sdorunts/Low-Freq-Amp/README.md

# Low-Freq-Amp
My analog circuitry engineering course work
