sdorunts/Low-Freq-Amp/Documentation/Presentation.pptx

МИНИСТЕРСТВО НАУКИ И ВЫСШЕГО ОБРАЗОВАНИЯ РОССИЙСКОЙ ФЕДЕРАЦИИ
МОСКОВСКИЙ ГОСУДАРСТВЕННЫЙ ТЕХНИЧЕСКИЙ УНИВЕРСИТЕТ
ИМ. Н.Э. БАУМАНА
КАФЕДРА ПРОЕКТИРОВАНИЕ И ТЕХНОЛОГИЯ ПРОИЗВОДСТВА ЭЛЕКТРОННОЙ АППАРАТУРЫ


Отчет о выполнении курсового проекта по предмету «Основы аналогово-цифровой схемотехники» по теме «Разработка, моделирование и экспериментальные исследования усилителя низкой частоты»


Выполнил: студент группы ИУ4-52Б
Дорунц Ш.А.
Проверил: д.т.н., профессор, профессор каф. ИУ-4
Семенцов С.Г.



Москва, 2023 г.

## Slide 2

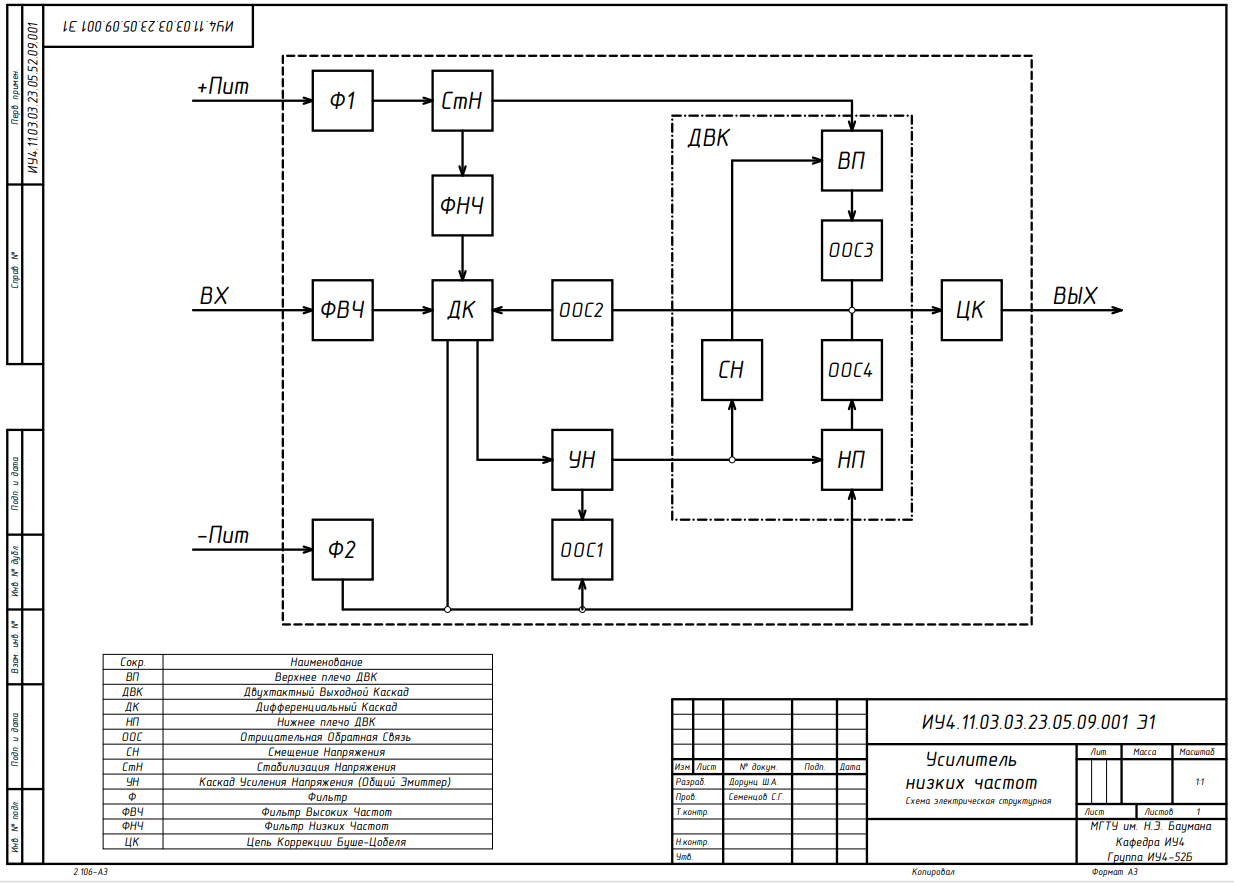
[picture p1: figure]

## Slide 3

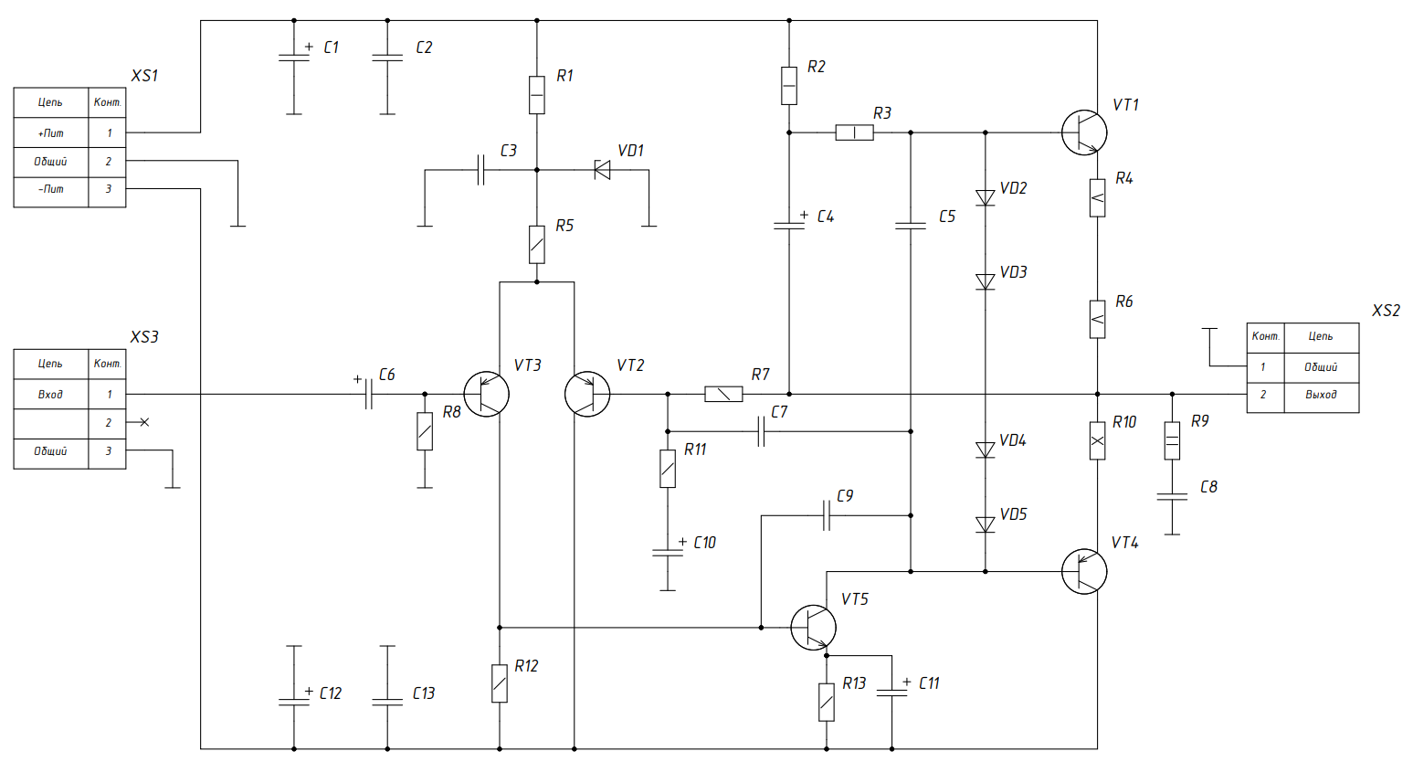
[picture p2: figure]

## Slide 4

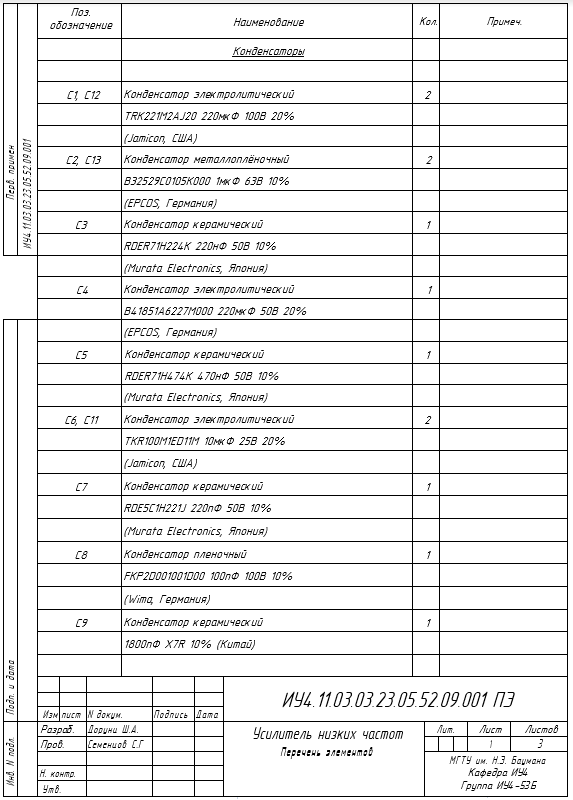
[picture p3: figure]
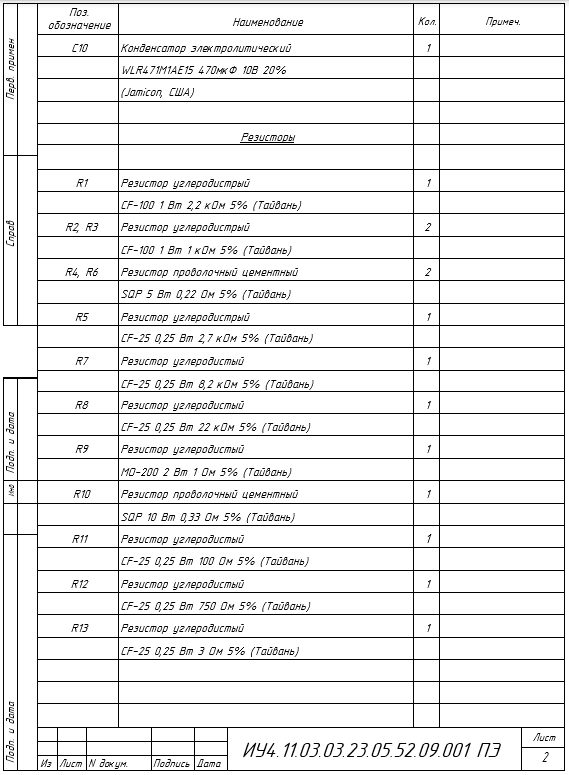
[picture p4: figure]

## Slide 5

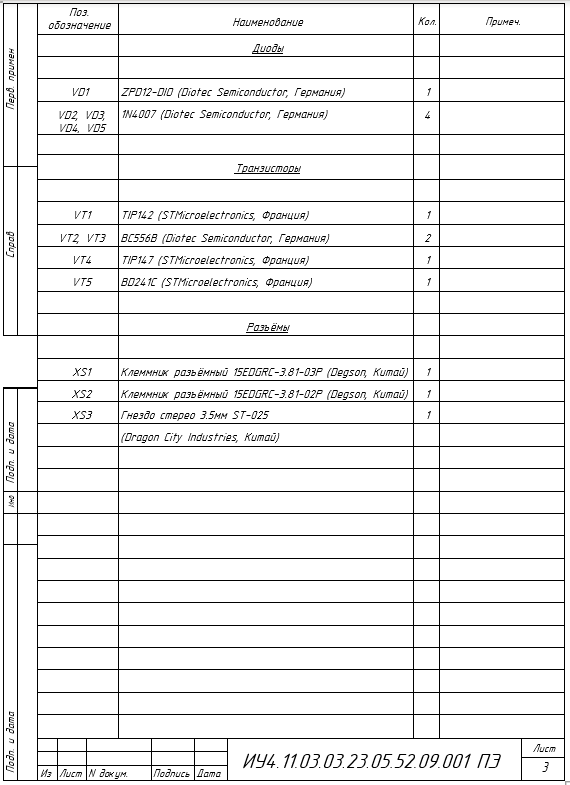
[picture p5: figure]

## Slide 6

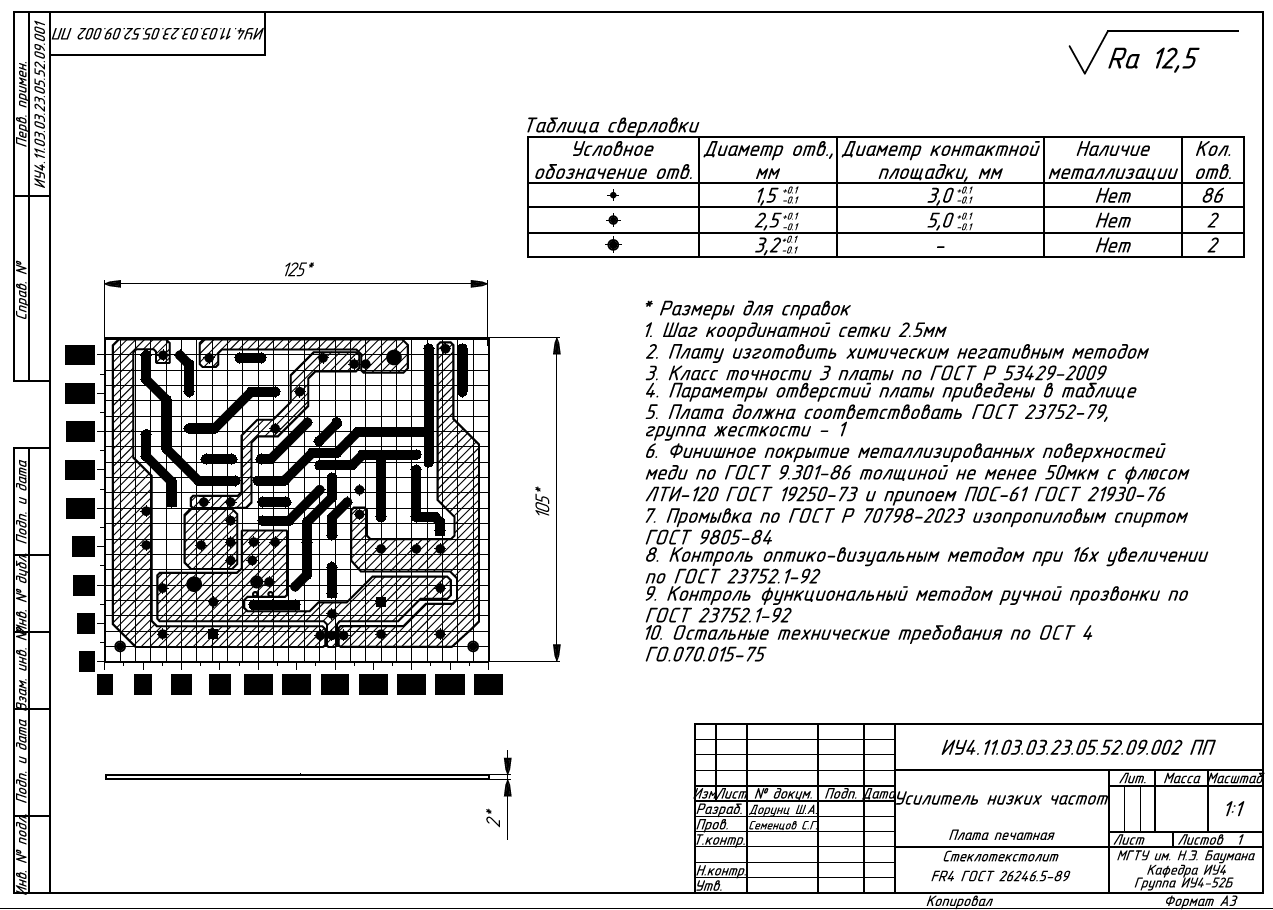
[picture p6: figure]
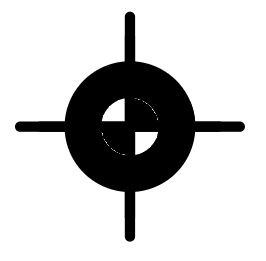
[picture p7: figure]
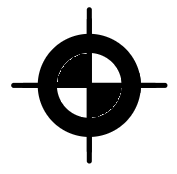
[picture p8: figure]
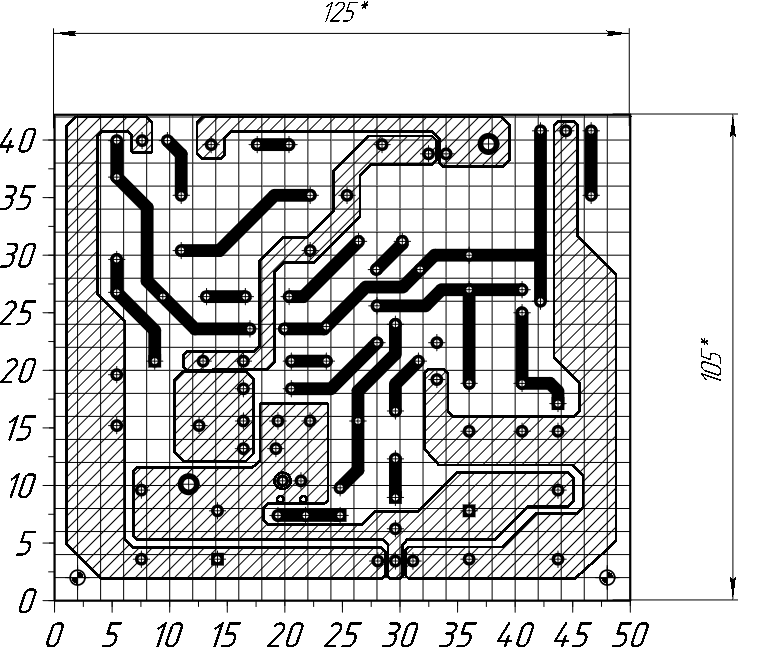
[picture p9: figure]
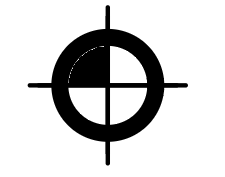
[picture p10: figure]

## Slide 7

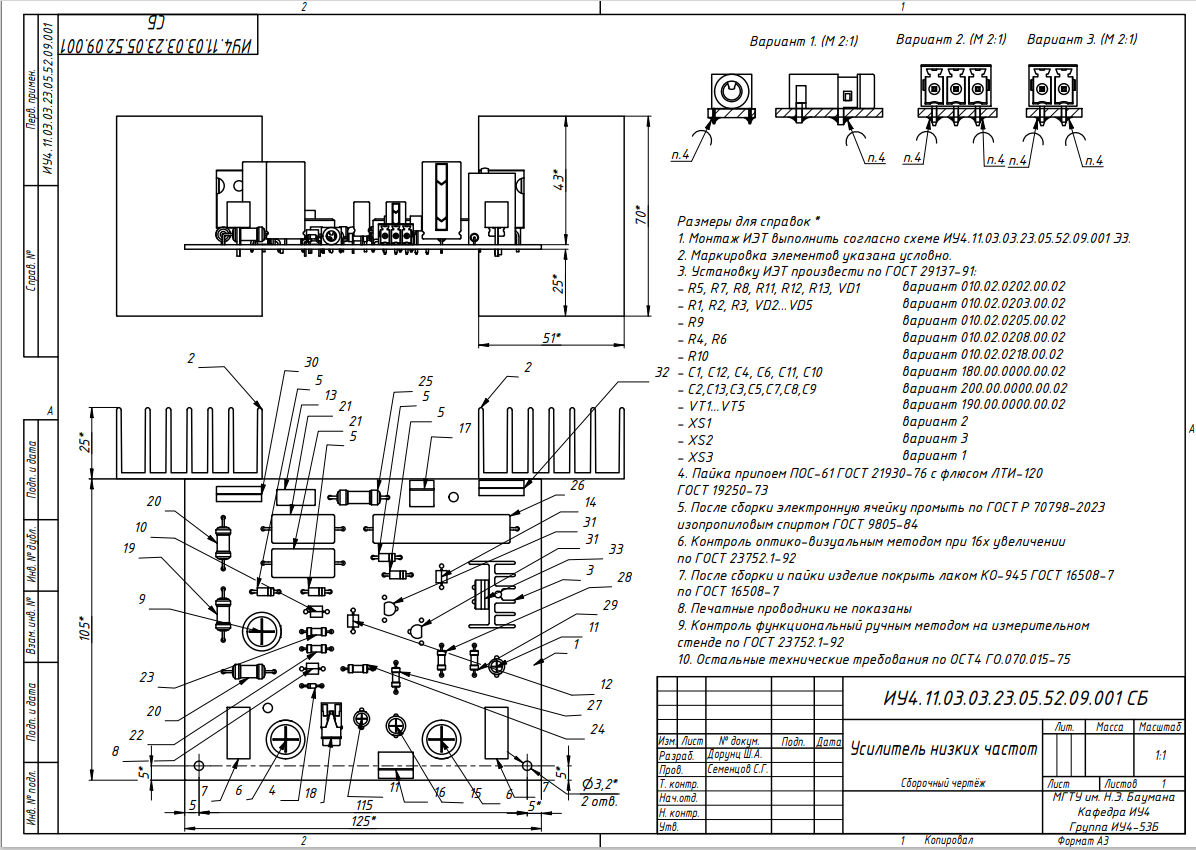
[picture p11: figure]

## Slide 8

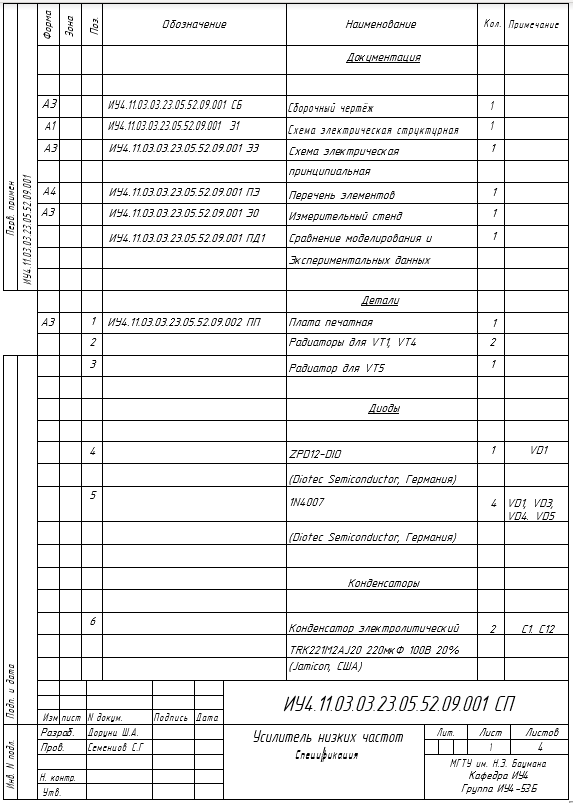
[picture p12: figure]
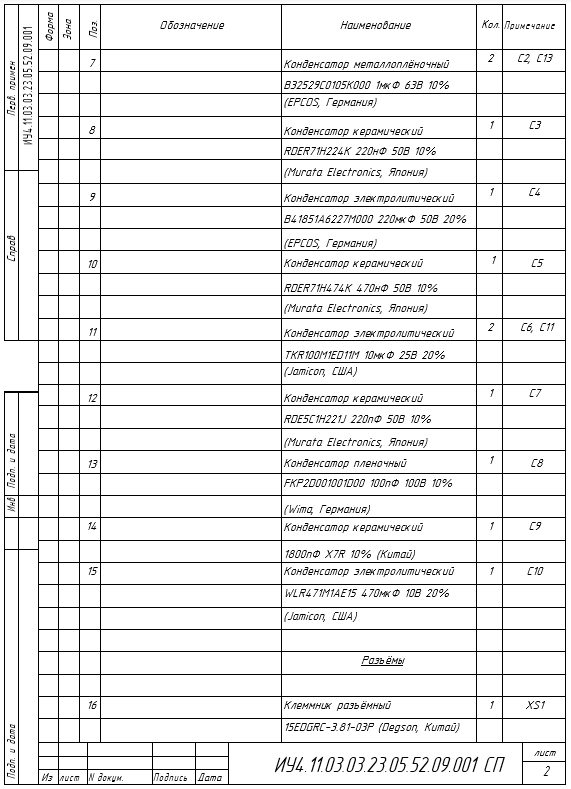
[picture p13: figure]

## Slide 9

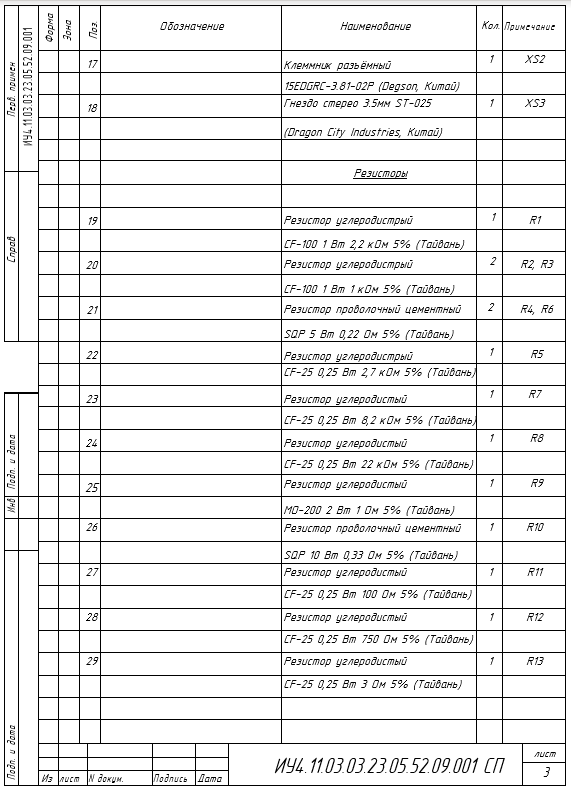
[picture p14: figure]
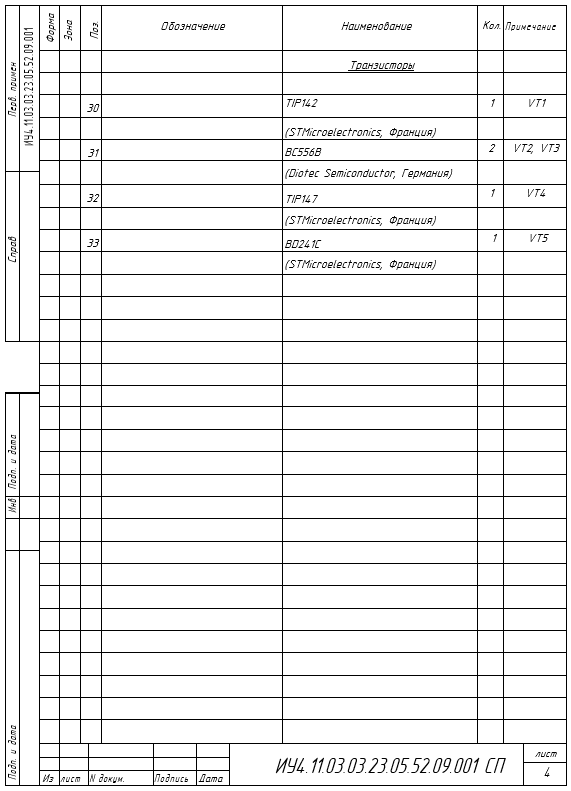
[picture p15: figure]

## Slide 10

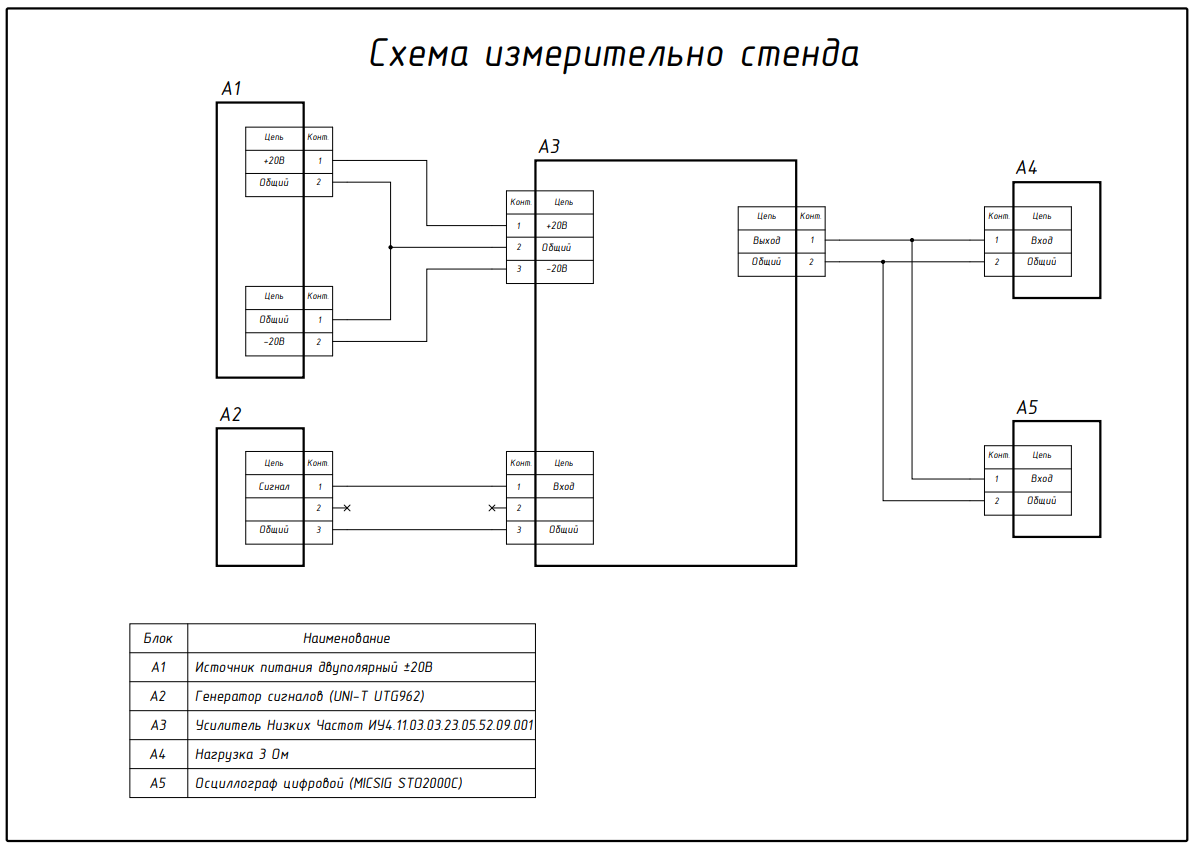
[picture p16: figure]

## Slide 11

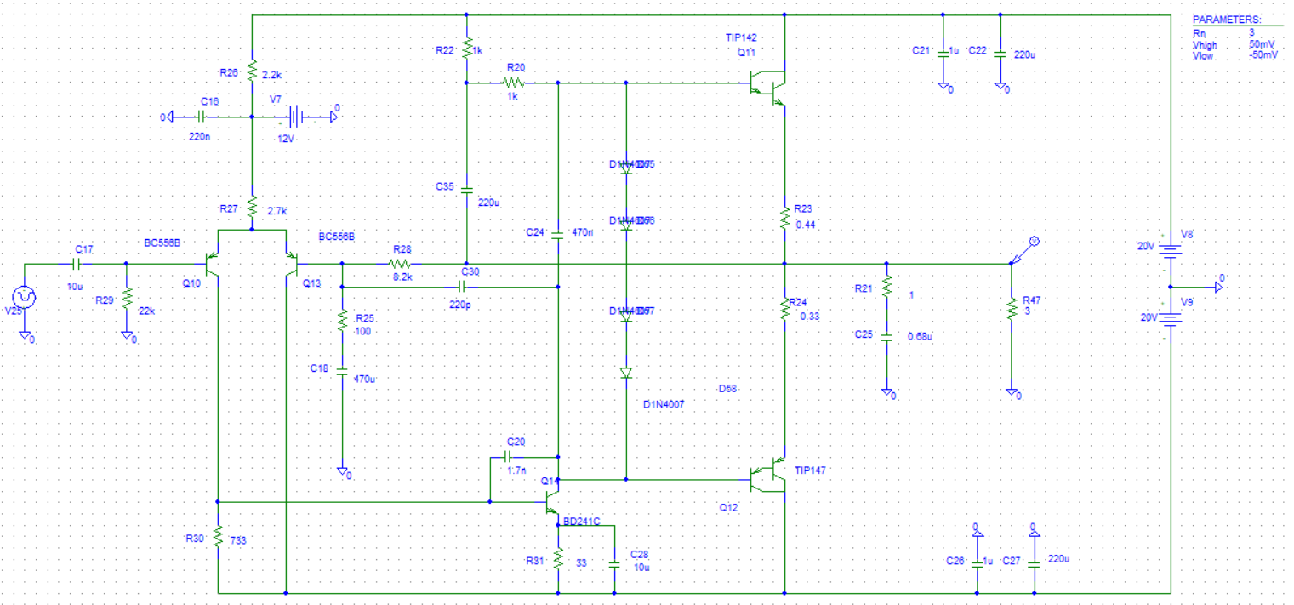
[picture p17: figure]

## Slide 12

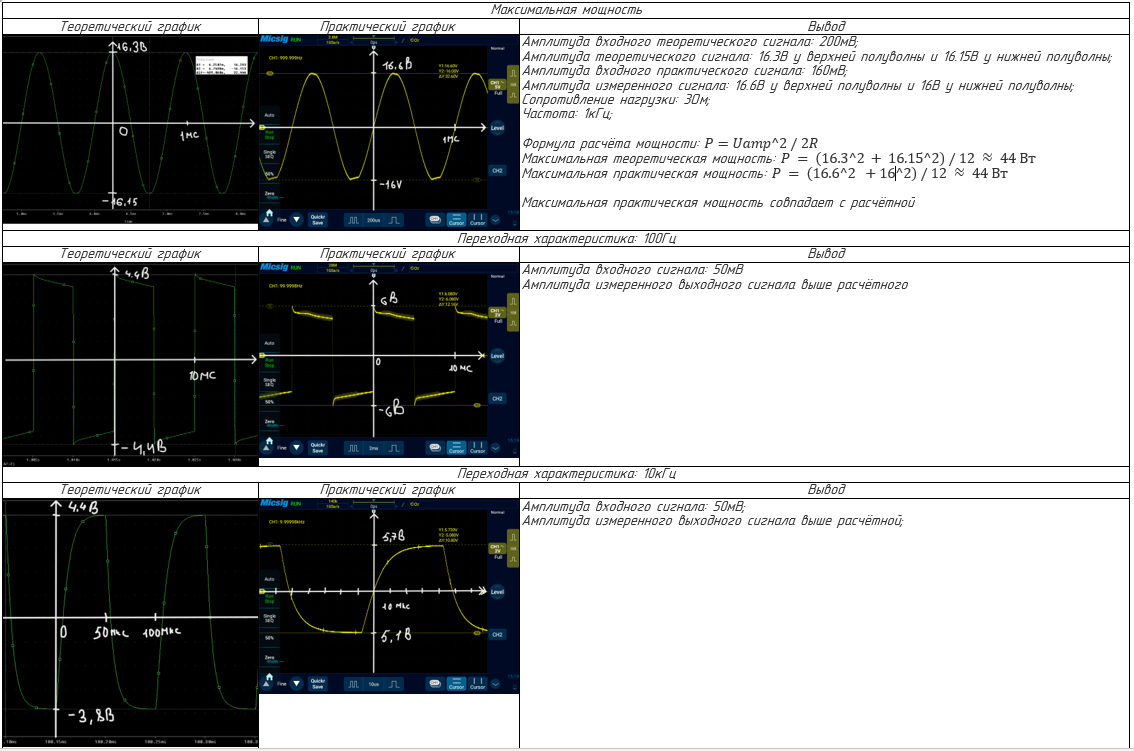
[picture p18: figure]

## Slide 13

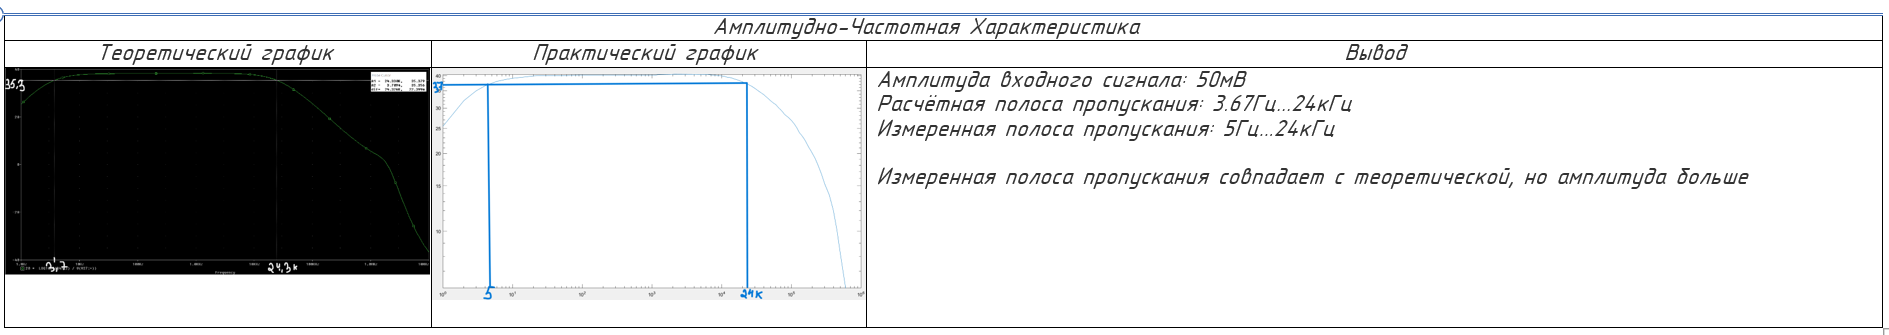
[picture p19: figure]
