sdorunts/Low-Freq-Amp/Documentation/ПД2_Дорунц.docx

Максимальная мощность
Теоретический график | Практический график | Вывод

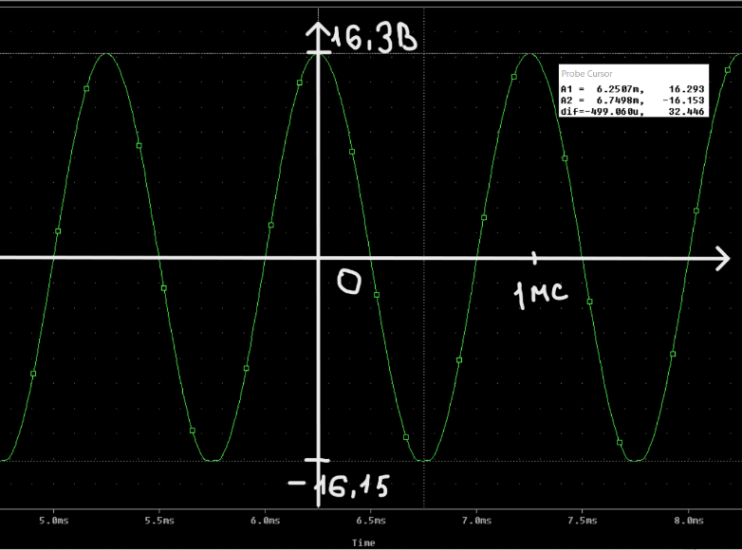
[picture p20: figure]
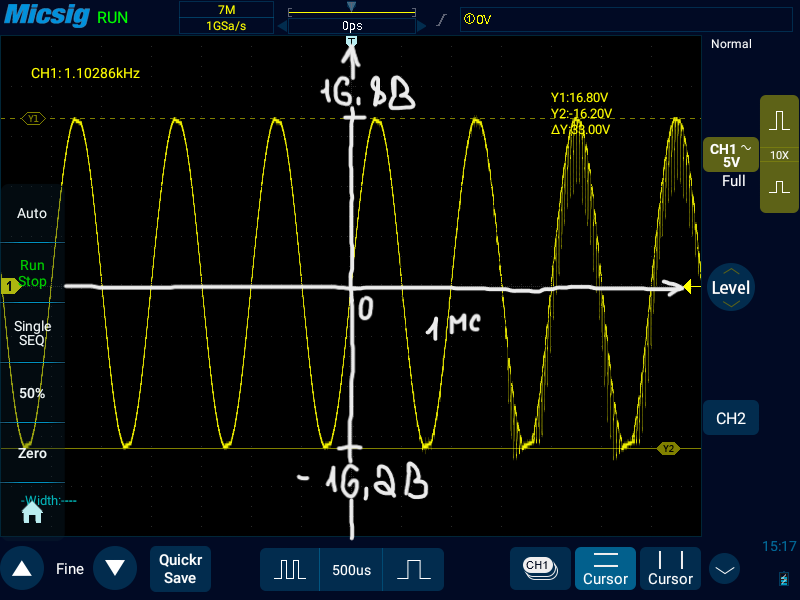
[picture p21: figure]

| | Амплитуда входного теоретического сигнала: 200мВ; Амплитуда теоретического сигнала: 16.3В у верхней полуволны и 16.15В у нижней полуволны; Амплитуда входного практического сигнала: 160мВ; Амплитуда измеренного сигнала: 16.8В у верхней полуволны и 16.2В у нижней полуволны; Сопротивление нагрузки: 3Ом; Частота: 1кГц; Формула расчёта мощности: P=Uamp^2 / 2R Максимальная теоретическая мощность: P = (16.3^2 + 16.15^2) / 6 ≈ 88 Вт Максимальная практическая мощность: P = (16.8^2 +16.2^2) / 6 ≈ 91 Вт Максимальная практическая мощность практически совпадает с расчётной

Переходная характеристика: 100Гц
Теоретический график | Практический график | Вывод

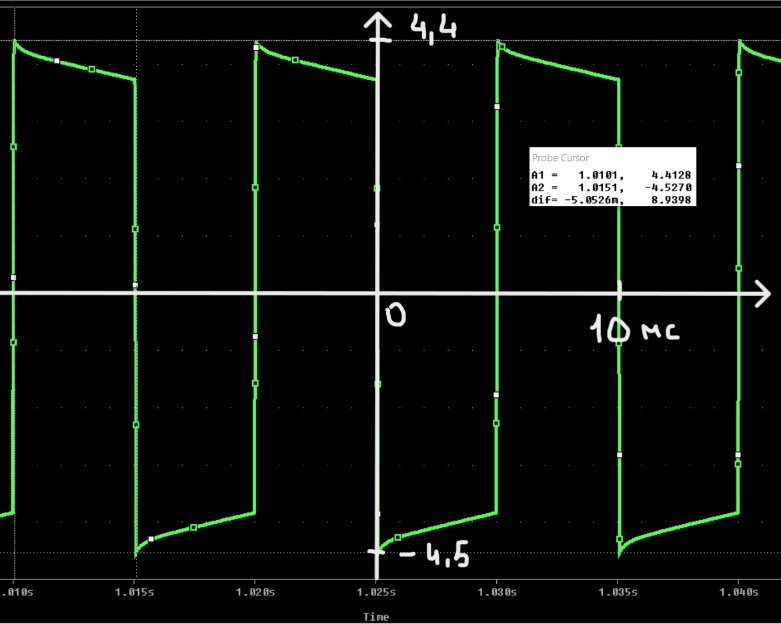
[picture p22: figure]
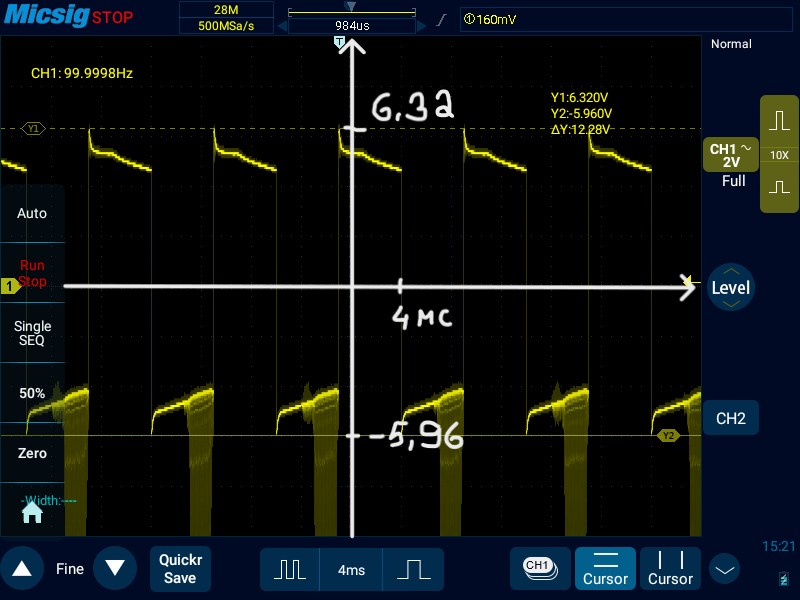
[picture p23: figure]

| | Амплитуда входного сигнала: 50мВ Амплитуда измеренного выходного сигнала выше расчётного

Переходная характеристика: 10кГц
Теоретический график | Практический график | Вывод

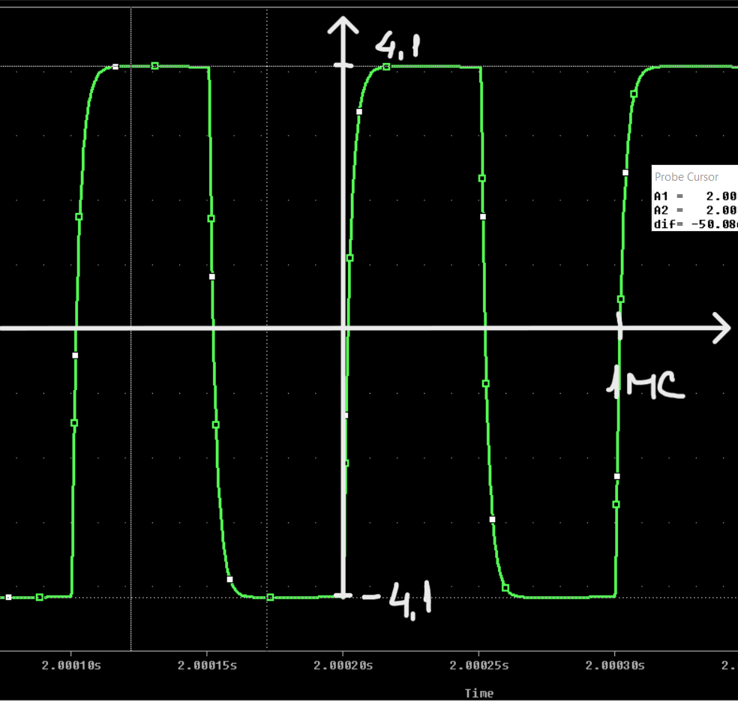
[picture p24: figure]
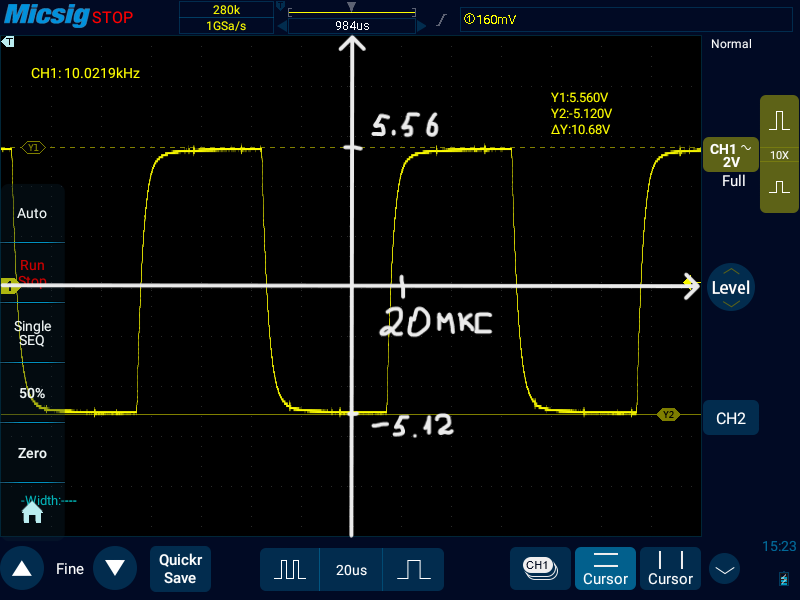
[picture p25: figure]

| | Амплитуда входного сигнала: 50мВ; Амплитуда измеренного выходного сигнала выше расчётной;

Амплитудно-Частотная Характеристика
Теоретический график | Практический график | Вывод

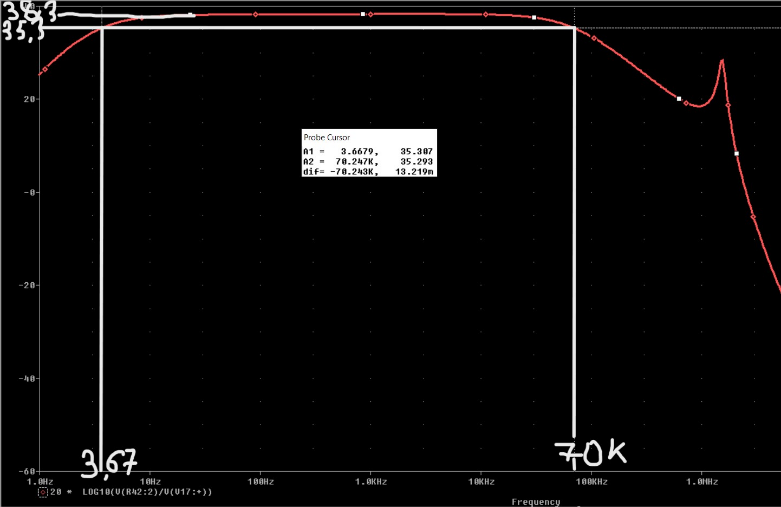
[picture p26: figure]
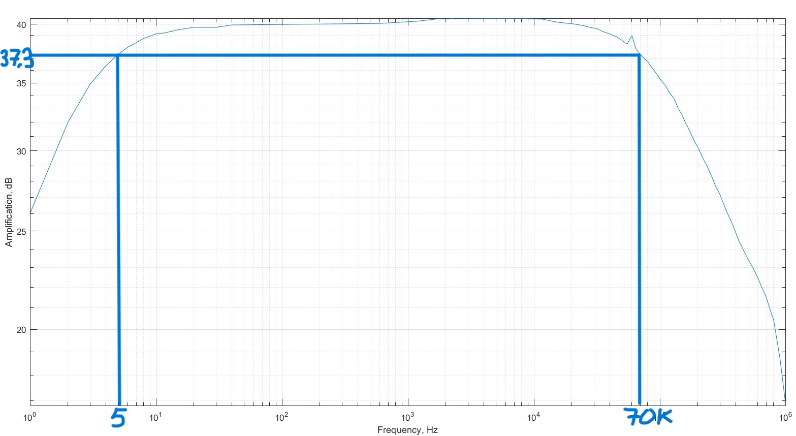
[picture p27: figure]

| | Амплитуда входного сигнала: 50мВ Расчётная полоса пропускания: 3.67Гц...70кГц Измеренная полоса пропускания: 5Гц...70кГц Измеренная полоса пропускания совпадает с теоретической, но амплитуда больше
