sdorunts/Low-Freq-Amp/Ar. sdorunts. Kurs. Osc/AFC; Vin=50mV; Rn=3Ohm; practical; marked.png

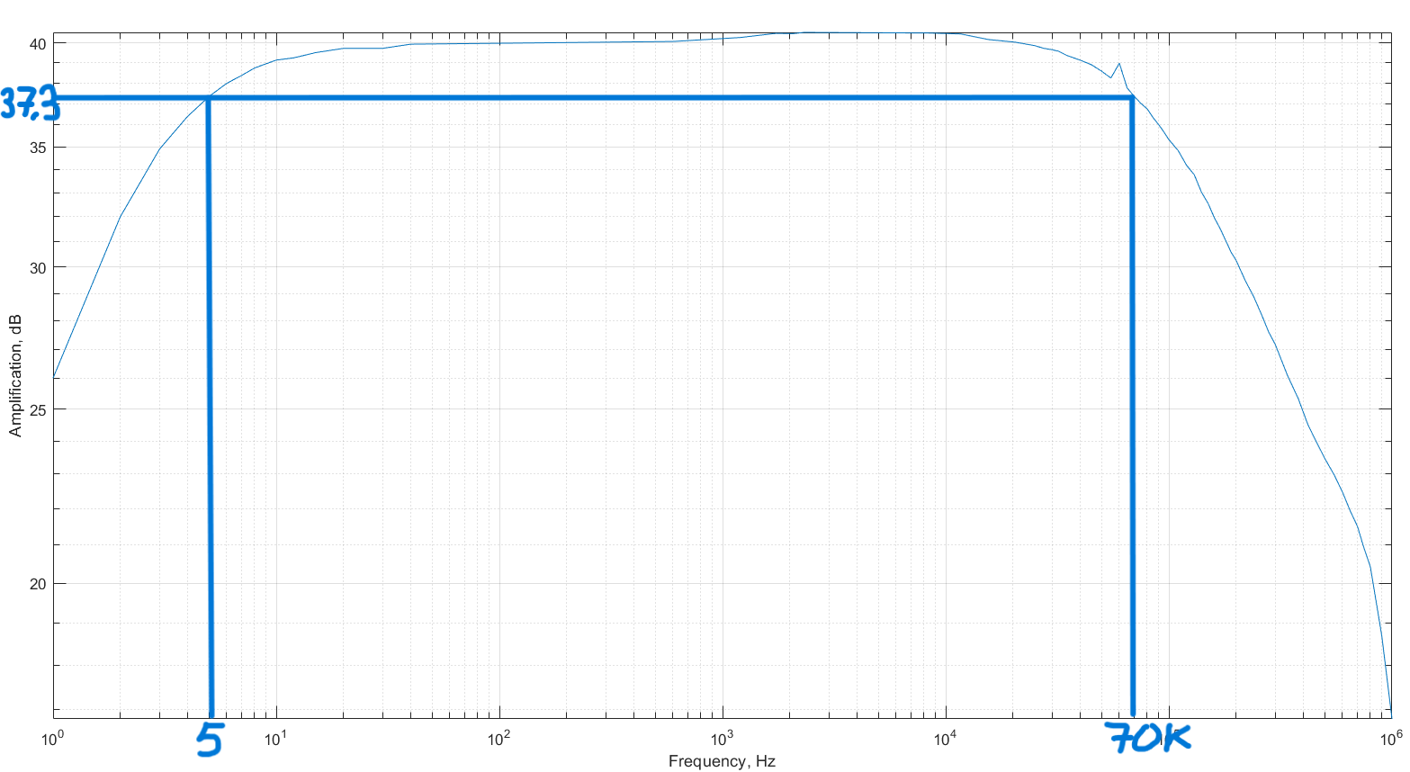
Ar. sdorunts. Kurs. Osc/AFC; Vin=50mV; Rn=3Ohm; practical; marked.png
