sdorunts/Low-Freq-Amp/Ar. sdorunts. Kurs. Osc/Screenshot_2023-12-09-14-33-51.png

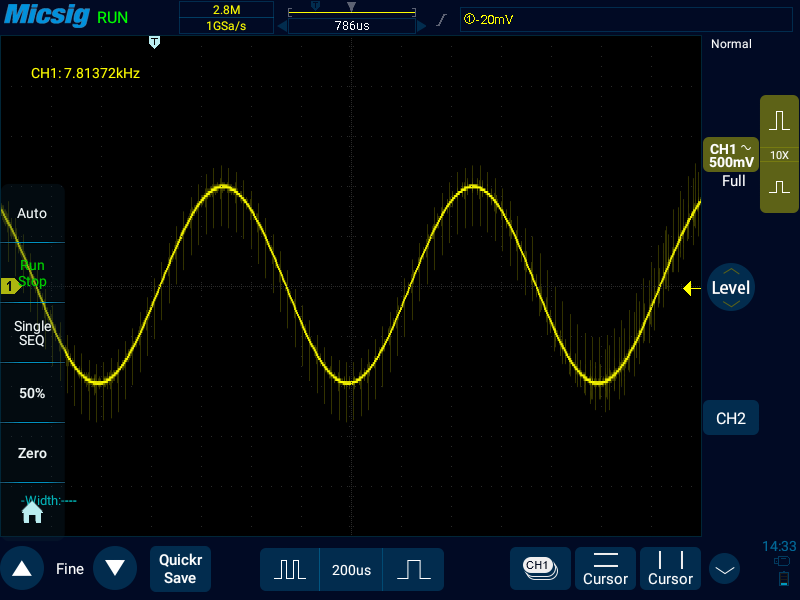
Ar. sdorunts. Kurs. Osc/Screenshot_2023-12-09-14-33-51.png
