sdorunts/Low-Freq-Amp/Ar. sdorunts. Kurs. Osc/Screenshot_2023-12-09-15-18-03.png

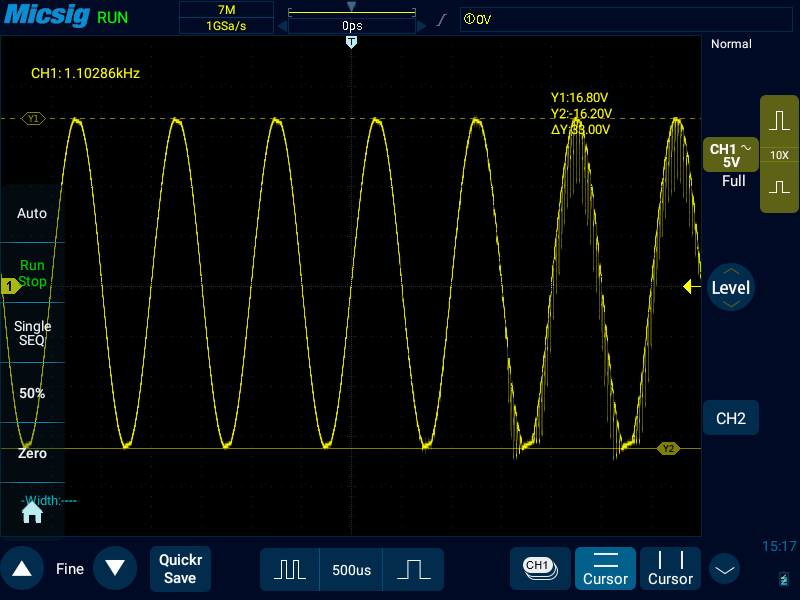
Ar. sdorunts. Kurs. Osc/Screenshot_2023-12-09-15-18-03.png
