sdorunts/Low-Freq-Amp/Ar. sdorunts. Kurs. Osc/Screenshot_2023-12-09-15-22-10.png

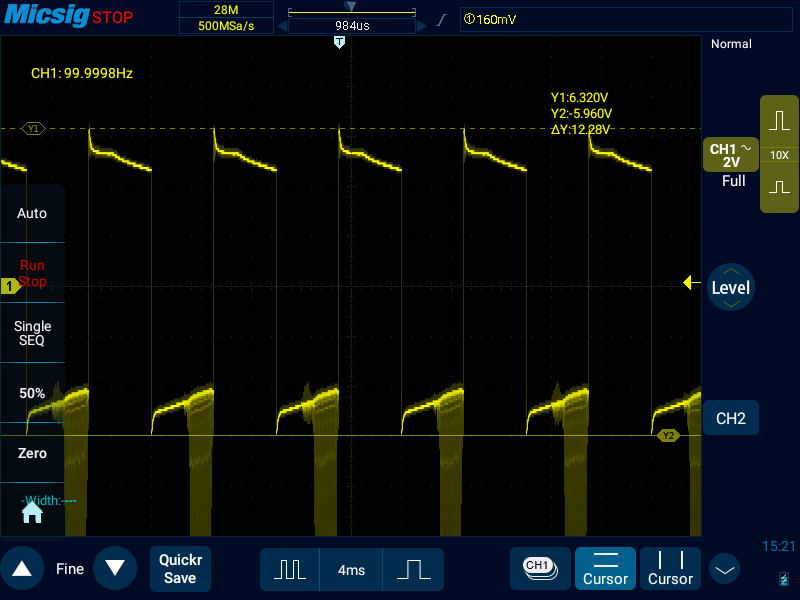
Ar. sdorunts. Kurs. Osc/Screenshot_2023-12-09-15-22-10.png
