sdorunts/Low-Freq-Amp/Ar. sdorunts. Kurs. Osc/Screenshot_2023-12-09-15-40-26.png

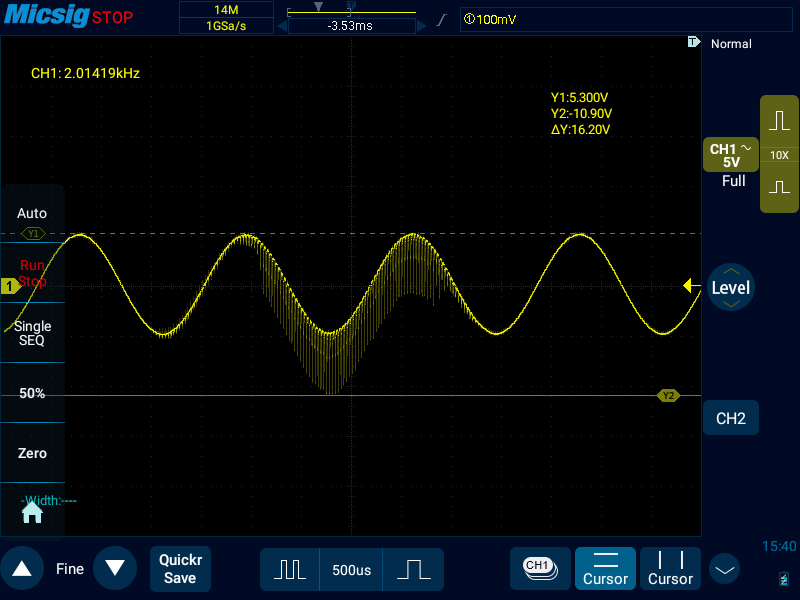
Ar. sdorunts. Kurs. Osc/Screenshot_2023-12-09-15-40-26.png
