sdorunts/Low-Freq-Amp/Ar. sdorunts. Kurs. Osc/Screenshot_2023-12-09-16-49-15.png

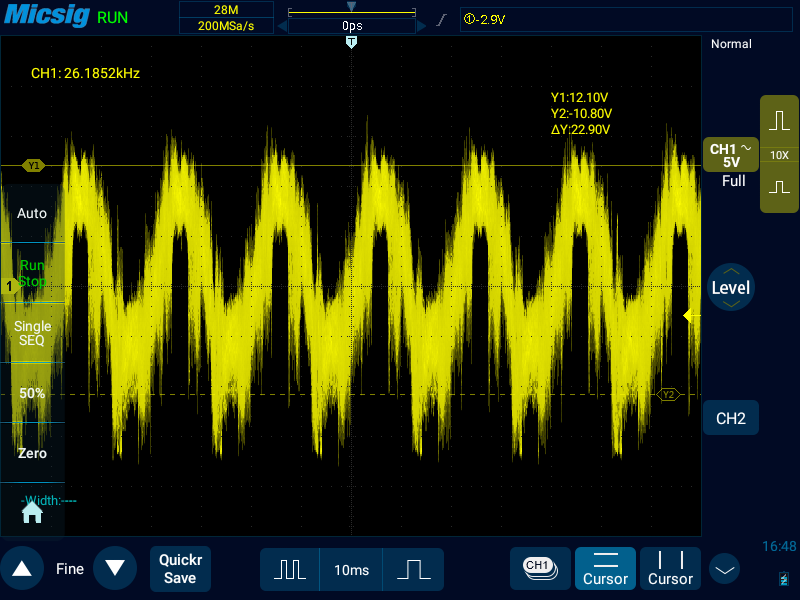
Ar. sdorunts. Kurs. Osc/Screenshot_2023-12-09-16-49-15.png
