sdorunts/Low-Freq-Amp/Ar. sdorunts. Kurs. Osc/Screenshot_2023-12-09-18-22-20.png

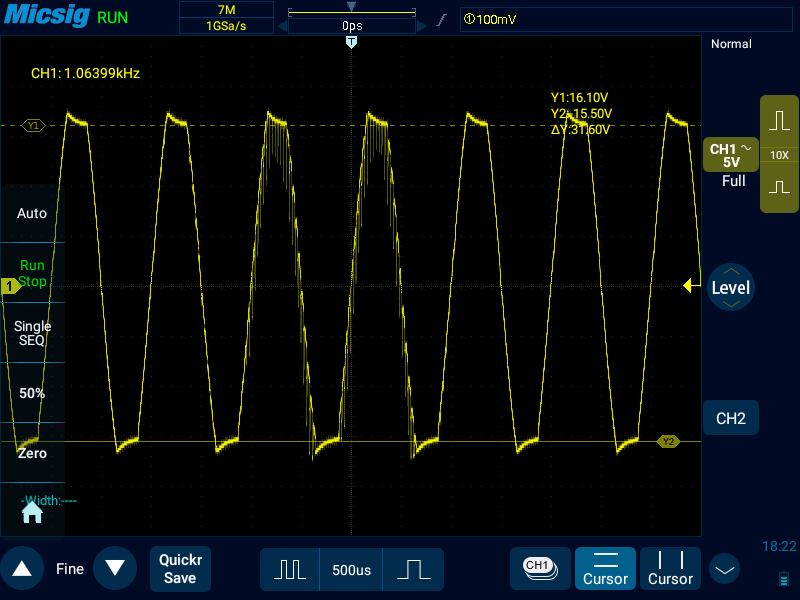
Ar. sdorunts. Kurs. Osc/Screenshot_2023-12-09-18-22-20.png
