sdorunts/Low-Freq-Amp/Documentation/Осциллограммы/АЧХ.PNG

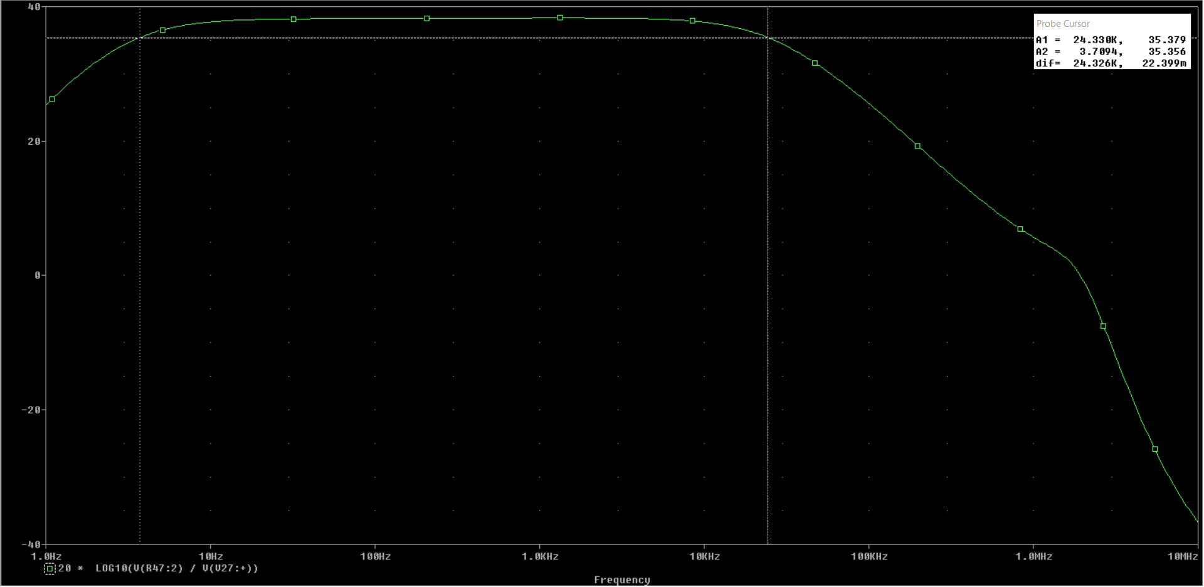
Documentation/Осциллограммы/АЧХ.PNG
