sdorunts/Low-Freq-Amp/Documentation/Осциллограммы/АЧХ_практика.PNG

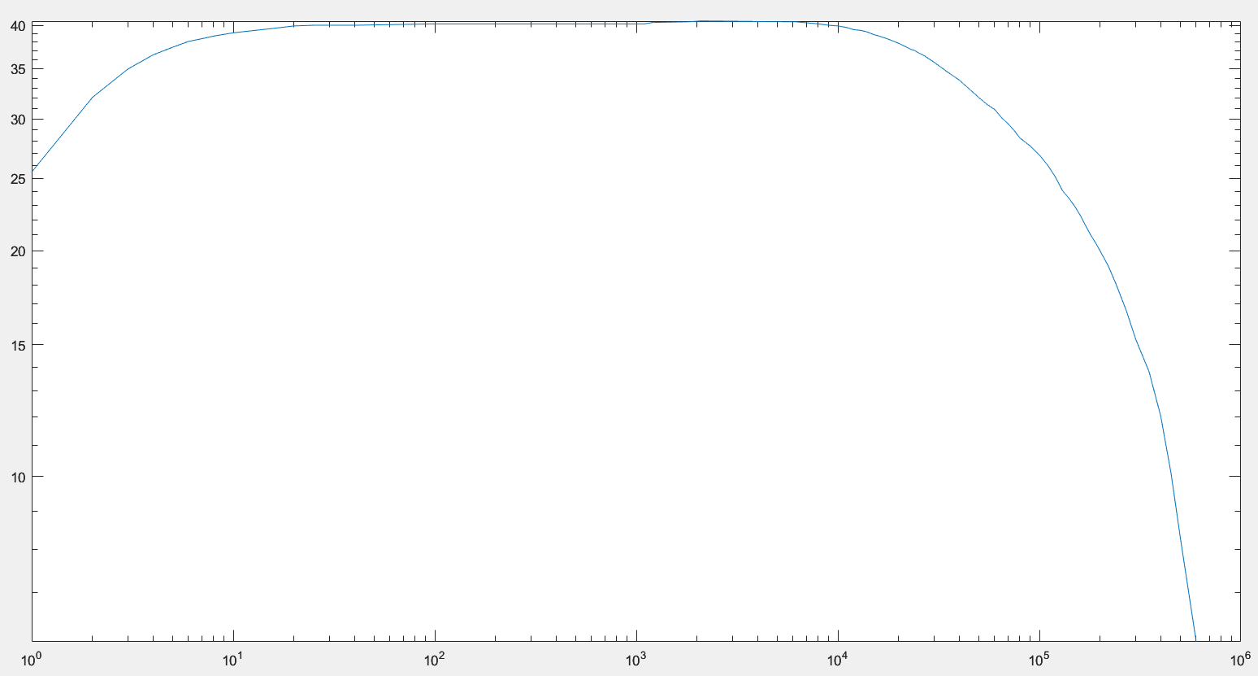
Documentation/Осциллограммы/АЧХ_практика.PNG
