sdorunts/Low-Freq-Amp/Documentation/Осциллограммы/Переходная. 10кГц.PNG

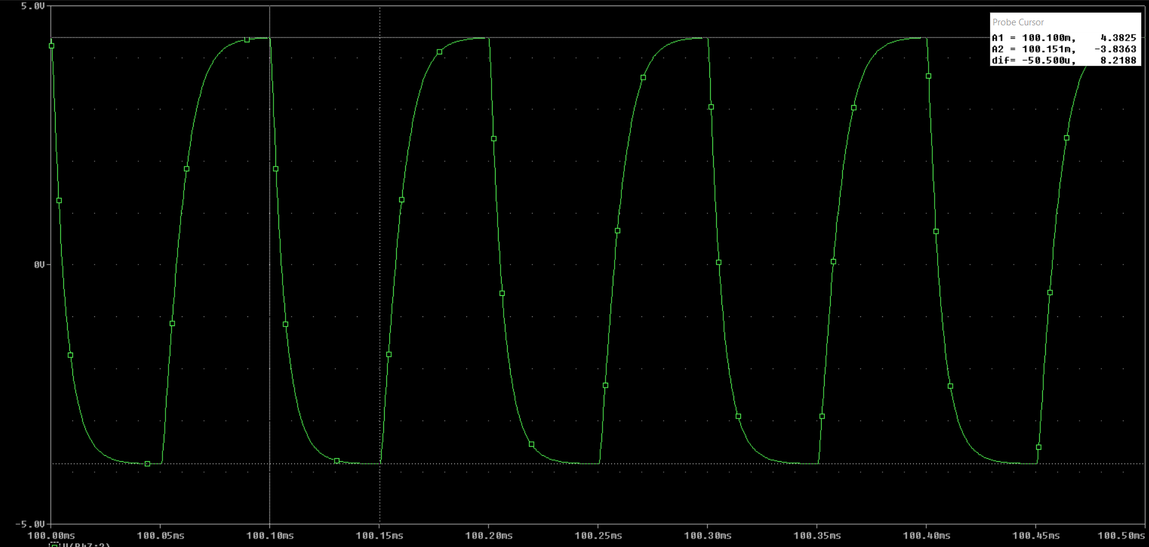
Documentation/Осциллограммы/Переходная. 10кГц.PNG
