sdorunts/Low-Freq-Amp/Documentation/Осциллограммы/Переходная. 100Гц.PNG

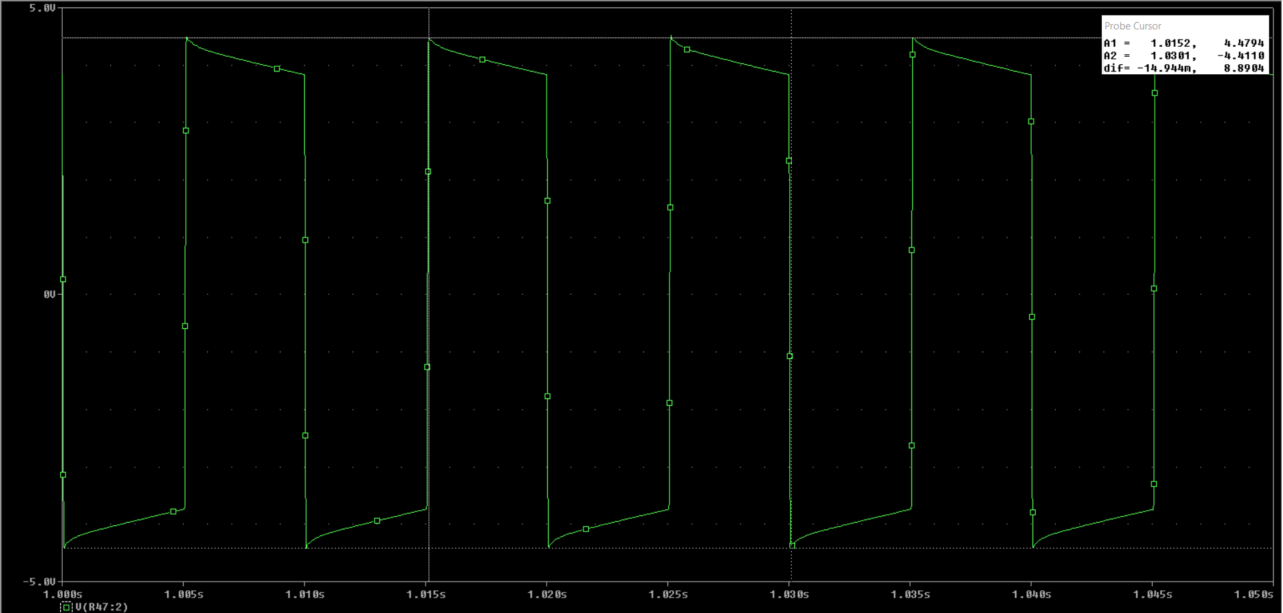
Documentation/Осциллограммы/Переходная. 100Гц.PNG
