sdorunts/Low-Freq-Amp/Documentation/ПП_Дорунц.png

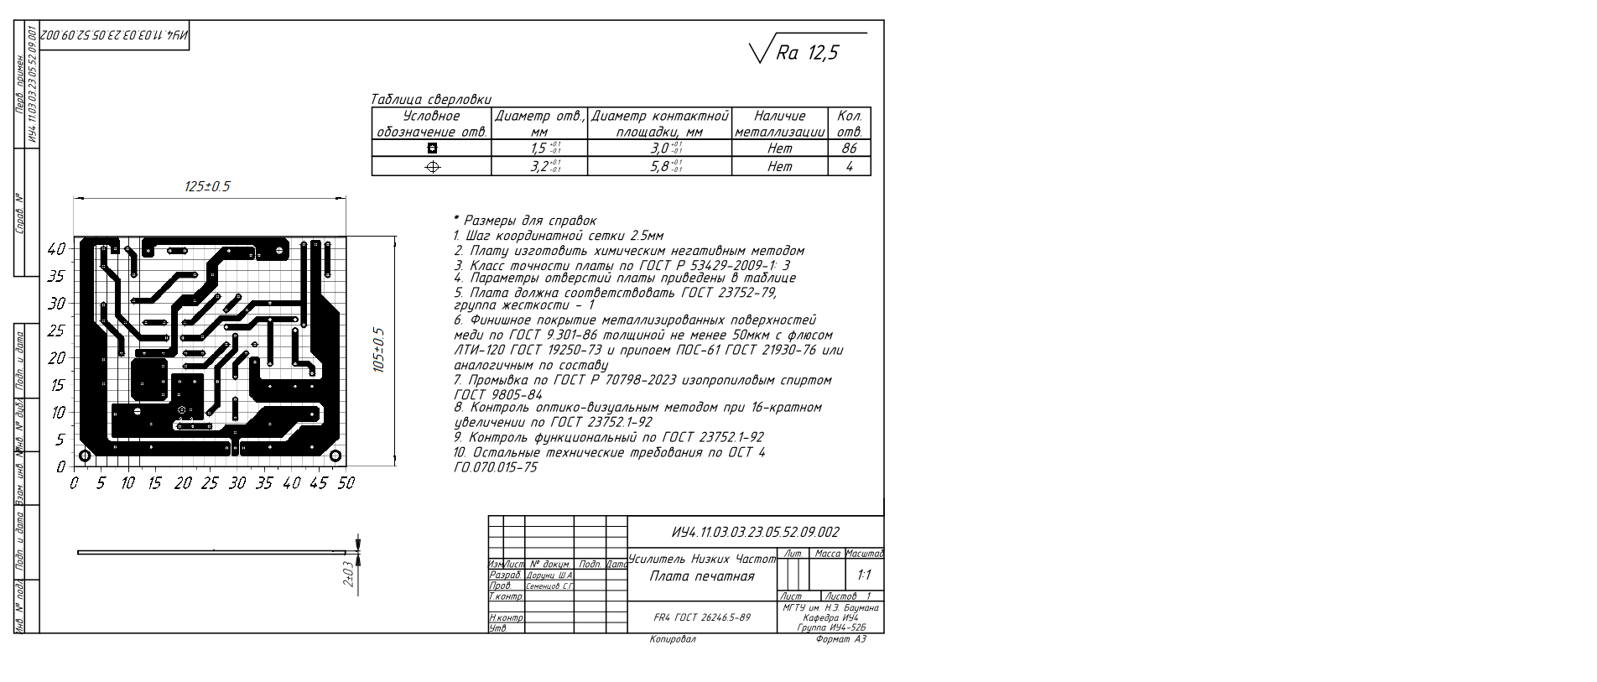
Documentation/ПП_Дорунц.png
