sdorunts/Low-Freq-Amp/Simulation/Graphics/AFC; Vin=50mV; Rn=3Ohm.PNG

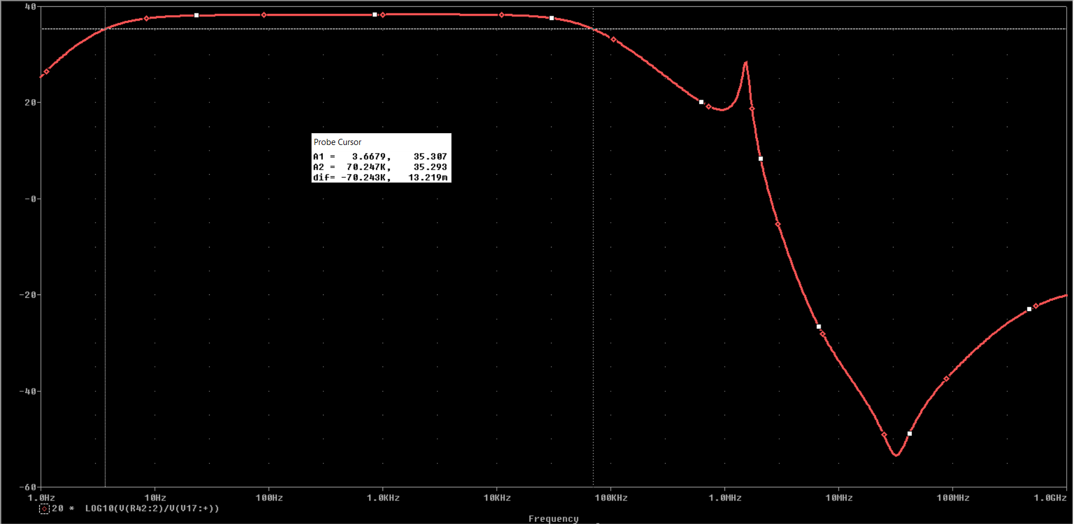
Simulation/Graphics/AFC; Vin=50mV; Rn=3Ohm.PNG
