sdorunts/Low-Freq-Amp/Simulation/Graphics/AFC; Vin=50mV; Rn=3Ohm; 0.5Meg;.PNG

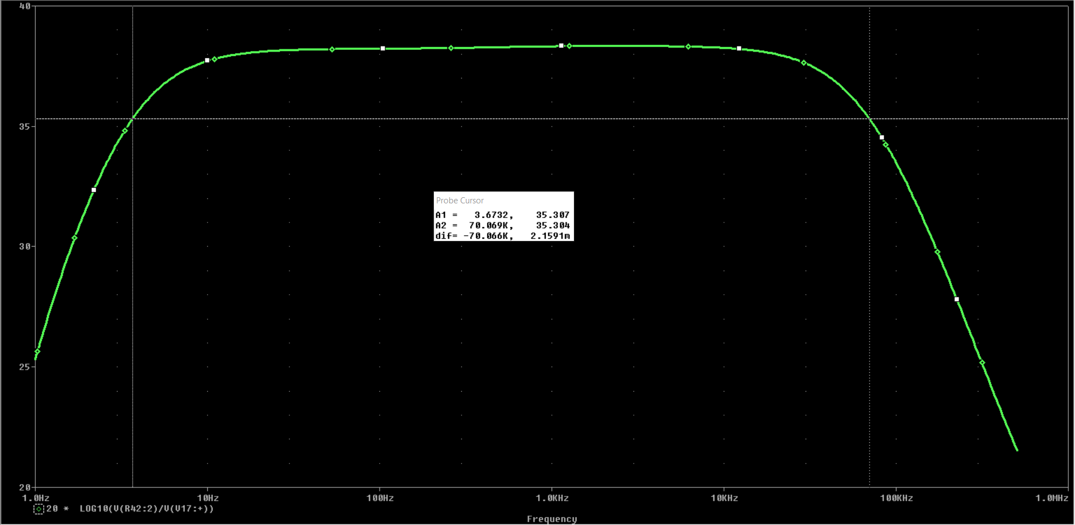
Simulation/Graphics/AFC; Vin=50mV; Rn=3Ohm; 0.5Meg;.PNG
