sdorunts/Low-Freq-Amp/Simulation/Graphics/Max. Power; Vin=200mV; Rn=3Ohm; f=1k.PNG

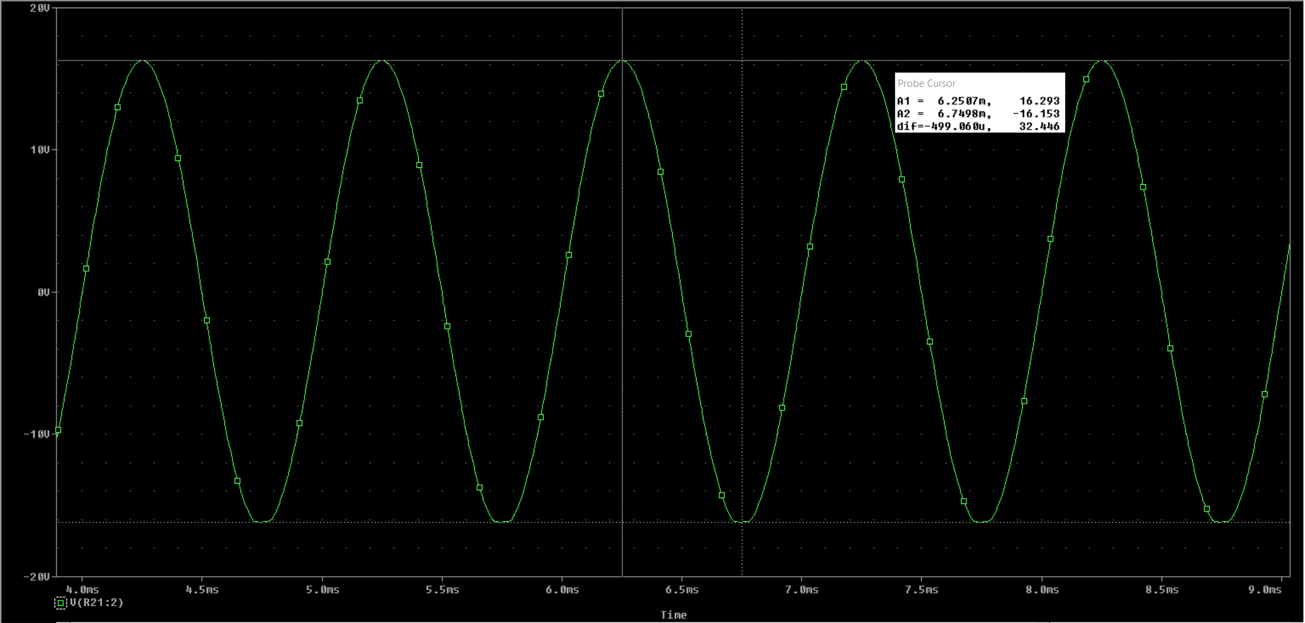
Simulation/Graphics/Max. Power; Vin=200mV; Rn=3Ohm; f=1k.PNG
