sdorunts/Low-Freq-Amp/Project Outputs for Kursovaya/PCBv2.step

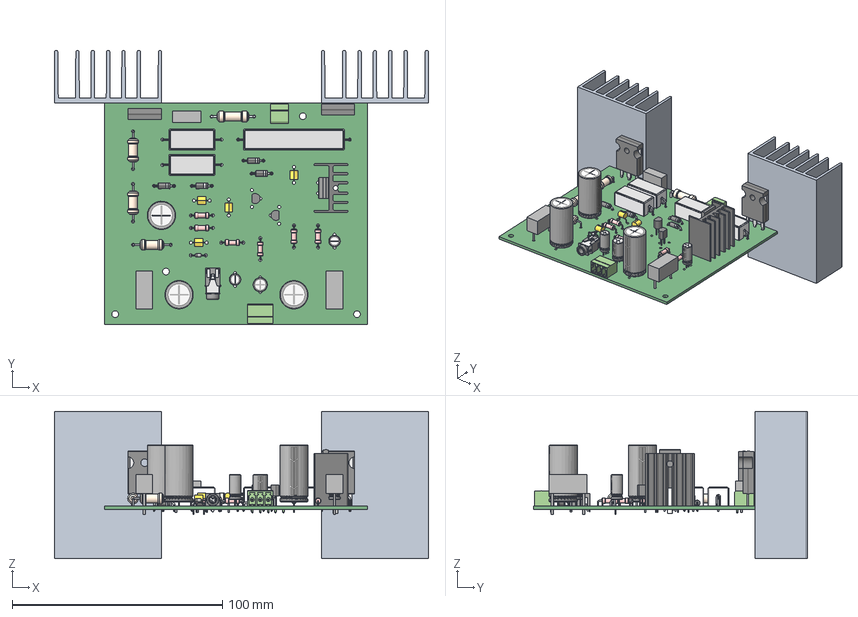
[picture p68: CAD file, 2023-12-19]
Project Outputs for Kursovaya/PCBv2.step
177.9 x 130.5 x 70.0 mm
RESAR2750W80L2200T1000H900_5W x 2
RESAR5334W80L4800T1000H900_10W
res-20.32_15.2x5.1
Telo konektora
Kontakt most
Kontakt 1
Kontakt 2
15EDGRC-3.81-02P-14-00A(H)_RGB5220458
15EDGRC-3.81-03P-14-00A(H)_RGB5220458
DO_41_375mil001 x 4
DO_41_375mil x 4
DO_41_375mil003 x 4
DO35_7mm-pitch
User Library-Transistors TO-220 FULLPAK 3-PIN
User Library-TO-247AC_plate_cuted x 2
User Library-TO-247AC_pino1 x 2
User Library-TO-247AC_pino2 x 2
User Library-TO-247AC_pino3 x 2
User Library-TO-247AC_body_finished x 2
User Library-TO-92B x 2
res-10.35_6.8x2.8 x 6
res-17.78_11.4x5.1 x 3
cappr-2_5.5h12 x 2
cappr-5_13.5h27 x 3
Extruded x 3
cappr-2.5_6.8h12
K10-17-0805 x 4
Radiator HS-123-25 v2
radiator x 2
