sdorunts/Low-Freq-Amp/(list of files, cad)

Other CAD files:
Documentation/PCBv2.dwg
Documentation/OldVersions/PCBv2.0011.dwg
Project Outputs for Kursovaya/PCBv2.dwg
Project Outputs for Kursovaya/PCBv2/15EDGRC-3.81-02P-14-00A(H)_RGB5220458.ipt
Project Outputs for Kursovaya/PCBv2/15EDGRC-3.81-03P-14-00A(H)_RGB5220458.ipt
Project Outputs for Kursovaya/PCBv2/6338724944.iam
Project Outputs for Kursovaya/PCBv2/6338725344.iam
Project Outputs for Kursovaya/PCBv2/6381688880.iam
Project Outputs for Kursovaya/PCBv2/6381689040.iam
Project Outputs for Kursovaya/PCBv2/Audio Jack 3.5 mm Cliff FC68125.iam
Project Outputs for Kursovaya/PCBv2/Board.iam
Project Outputs for Kursovaya/PCBv2/C1.iam
Project Outputs for Kursovaya/PCBv2/C10.iam
Project Outputs for Kursovaya/PCBv2/C11.iam
Project Outputs for Kursovaya/PCBv2/C12.iam
Project Outputs for Kursovaya/PCBv2/C13.iam
Project Outputs for Kursovaya/PCBv2/C2.iam
Project Outputs for Kursovaya/PCBv2/C3.iam
Project Outputs for Kursovaya/PCBv2/C4.iam
Project Outputs for Kursovaya/PCBv2/C5.iam
Project Outputs for Kursovaya/PCBv2/C6.iam
Project Outputs for Kursovaya/PCBv2/C7.iam
Project Outputs for Kursovaya/PCBv2/C8.iam
Project Outputs for Kursovaya/PCBv2/C9.iam
Project Outputs for Kursovaya/PCBv2/Cylinder.ipt
Project Outputs for Kursovaya/PCBv2/Cylinder_1.ipt
Project Outputs for Kursovaya/PCBv2/DO35_7mm-pitch.ipt
Project Outputs for Kursovaya/PCBv2/DO_41_375mil.ipt
Project Outputs for Kursovaya/PCBv2/DO_41_375mil001.ipt
Project Outputs for Kursovaya/PCBv2/DO_41_375mil003.ipt
Project Outputs for Kursovaya/PCBv2/Extruded.ipt
Project Outputs for Kursovaya/PCBv2/Extruded_1.ipt
Project Outputs for Kursovaya/PCBv2/Fillet.ipt
Project Outputs for Kursovaya/PCBv2/Fillet001.ipt
Project Outputs for Kursovaya/PCBv2/Free-Models.iam
Project Outputs for Kursovaya/PCBv2/K10-17-0805.ipt
Project Outputs for Kursovaya/PCBv2/Kontakt 1.ipt
Project Outputs for Kursovaya/PCBv2/Kontakt 2.ipt
Project Outputs for Kursovaya/PCBv2/Kontakt most.ipt
Project Outputs for Kursovaya/PCBv2/Open CASCADE STEP translator 7.5 1.1.1.ipt
Project Outputs for Kursovaya/PCBv2/PCBv2.iam
Project Outputs for Kursovaya/PCBv2/R1.iam
Project Outputs for Kursovaya/PCBv2/R10.iam
Project Outputs for Kursovaya/PCBv2/R11.iam
Project Outputs for Kursovaya/PCBv2/R12.iam
Project Outputs for Kursovaya/PCBv2/R13.iam
Project Outputs for Kursovaya/PCBv2/R2.iam
Project Outputs for Kursovaya/PCBv2/R3.iam
Project Outputs for Kursovaya/PCBv2/R4.iam
Project Outputs for Kursovaya/PCBv2/R5.iam
Project Outputs for Kursovaya/PCBv2/R6.iam
Project Outputs for Kursovaya/PCBv2/R7.iam
Project Outputs for Kursovaya/PCBv2/R8.iam
Project Outputs for Kursovaya/PCBv2/R9.iam
Project Outputs for Kursovaya/PCBv2/RESAR2750W80L2200T1000H900_5W.ipt
Project Outputs for Kursovaya/PCBv2/RESAR5334W80L4800T1000H900_10W.ipt
Project Outputs for Kursovaya/PCBv2/Radiator HS-123-25 v2.ipt
Project Outputs for Kursovaya/PCBv2/T1.iam
Project Outputs for Kursovaya/PCBv2/T2.iam
Project Outputs for Kursovaya/PCBv2/T3.iam
Project Outputs for Kursovaya/PCBv2/T4.iam
Project Outputs for Kursovaya/PCBv2/T5.iam
Project Outputs for Kursovaya/PCBv2/Telo konektora.ipt
Project Outputs for Kursovaya/PCBv2/User Library-DO-41_375mil.iam
Project Outputs for Kursovaya/PCBv2/User Library-TO-247AC.iam
Project Outputs for Kursovaya/PCBv2/User Library-TO-247AC_body_finished.ipt
Project Outputs for Kursovaya/PCBv2/User Library-TO-247AC_pino1.ipt
Project Outputs for Kursovaya/PCBv2/User Library-TO-247AC_pino2.ipt
Project Outputs for Kursovaya/PCBv2/User Library-TO-247AC_pino3.ipt
Project Outputs for Kursovaya/PCBv2/User Library-TO-247AC_plate_cuted.ipt
Project Outputs for Kursovaya/PCBv2/User Library-TO-92B.ipt
Project Outputs for Kursovaya/PCBv2/User Library-Transistors TO-220 FULLPAK 3-PIN.ipt
Project Outputs for Kursovaya/PCBv2/VD1.iam
Project Outputs for Kursovaya/PCBv2/VD2.iam
Project Outputs for Kursovaya/PCBv2/VD3.iam
Project Outputs for Kursovaya/PCBv2/VD4.iam
Project Outputs for Kursovaya/PCBv2/VD5.iam
Project Outputs for Kursovaya/PCBv2/XS1.iam
Project Outputs for Kursovaya/PCBv2/XS2.iam
Project Outputs for Kursovaya/PCBv2/XS3.iam
Project Outputs for Kursovaya/PCBv2/cappr-2.5_6.8h12.ipt
Project Outputs for Kursovaya/PCBv2/cappr-2_5.5h12.ipt
Project Outputs for Kursovaya/PCBv2/cappr-5_13.5h27.ipt
Project Outputs for Kursovaya/PCBv2/radiator.ipt
Project Outputs for Kursovaya/PCBv2/res-10.35_6.8x2.8.ipt
Project Outputs for Kursovaya/PCBv2/res-17.78_11.4x5.1.ipt
Project Outputs for Kursovaya/PCBv2/res-20.32_15.2x5.1.ipt
