sdorunts/Low-Freq-Amp/Simulation/Graphics/Transitional Characteristic; Vamp=50mV; Rn=3Ohm; f=10kHz; whitout Cursor.PNG

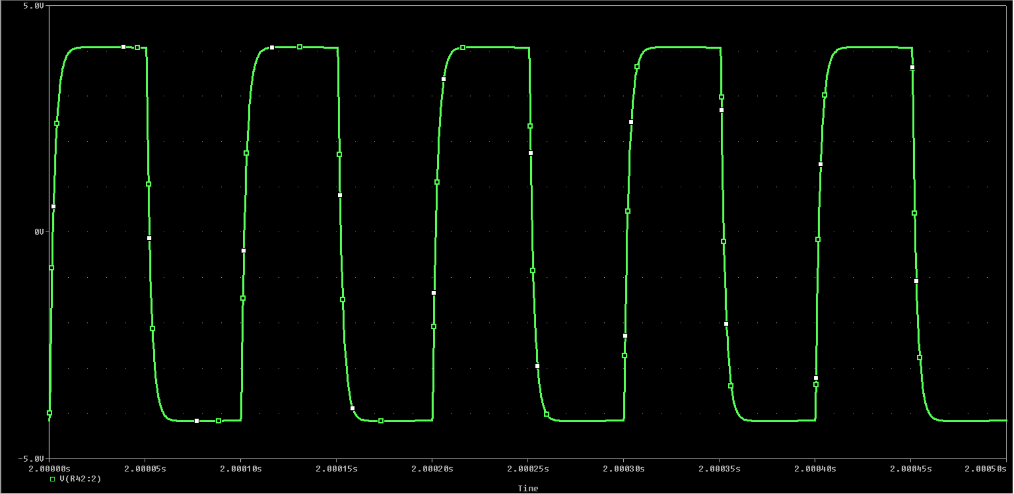
Simulation/Graphics/Transitional Characteristic; Vamp=50mV; Rn=3Ohm; f=10kHz; whitout Cursor.PNG
