sdorunts/Low-Freq-Amp/Simulation/Graphics/Transitional Characteristic; Vamp=50mV; Rn=3Ohm; f=100Hz.PNG

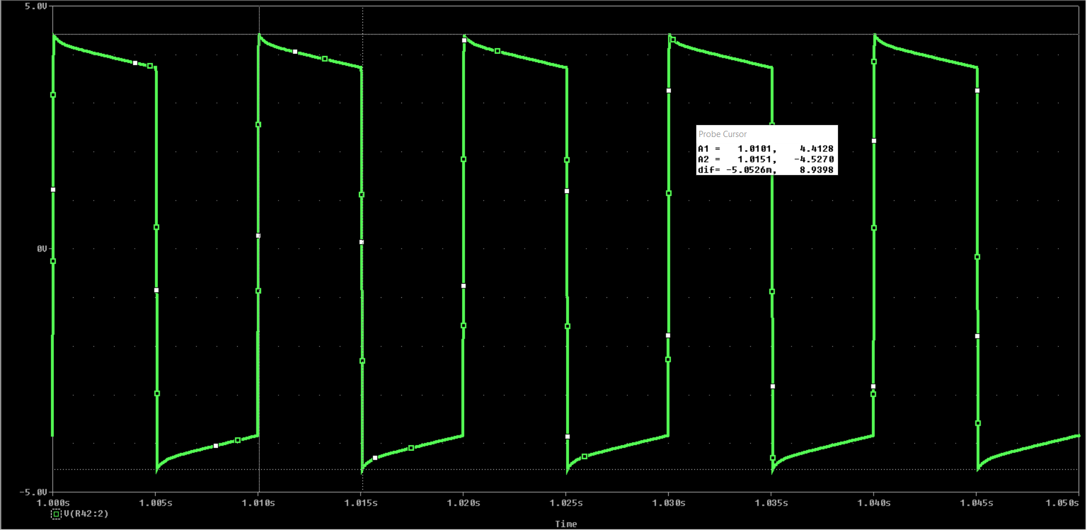
Simulation/Graphics/Transitional Characteristic; Vamp=50mV; Rn=3Ohm; f=100Hz.PNG
