sdorunts/Low-Freq-Amp/ИС.pdf

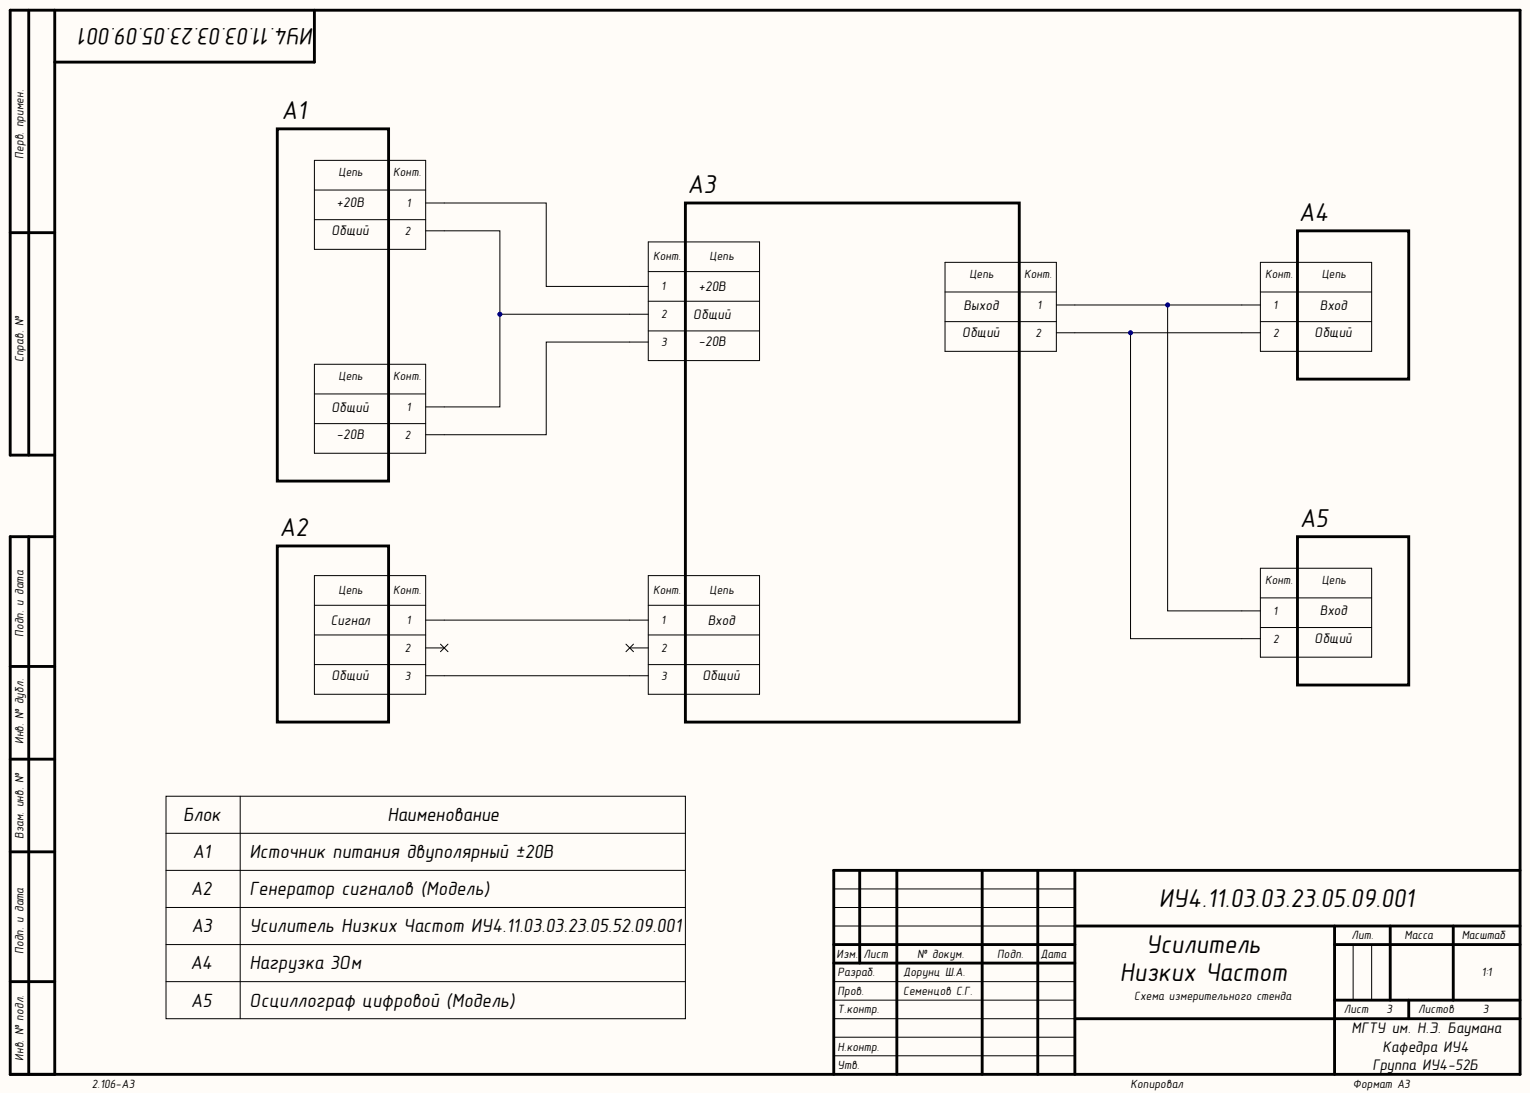
[picture p73: page 1]

Инв. № подл. Инв. № дубл. Подп. и дата Взам. инв. № Подп. и дата Перв. примен. Справ. №

Цепь | Конт.

Общий | 2

Конт. | Цепь

2 | Общий

Общий | 1

1 | Вход

Блок | Наименование

А1 | Источник питания двуполярный ±20В

Т.контр. | Лист 3 | Листов 3

МГТУ им. Н.Э. Баумана Кафедра ИУ4 Группа ИУ4-52Б

Н.контр.
Утв.
