sdorunts/Low-Freq-Amp/Kursovaya.pdf

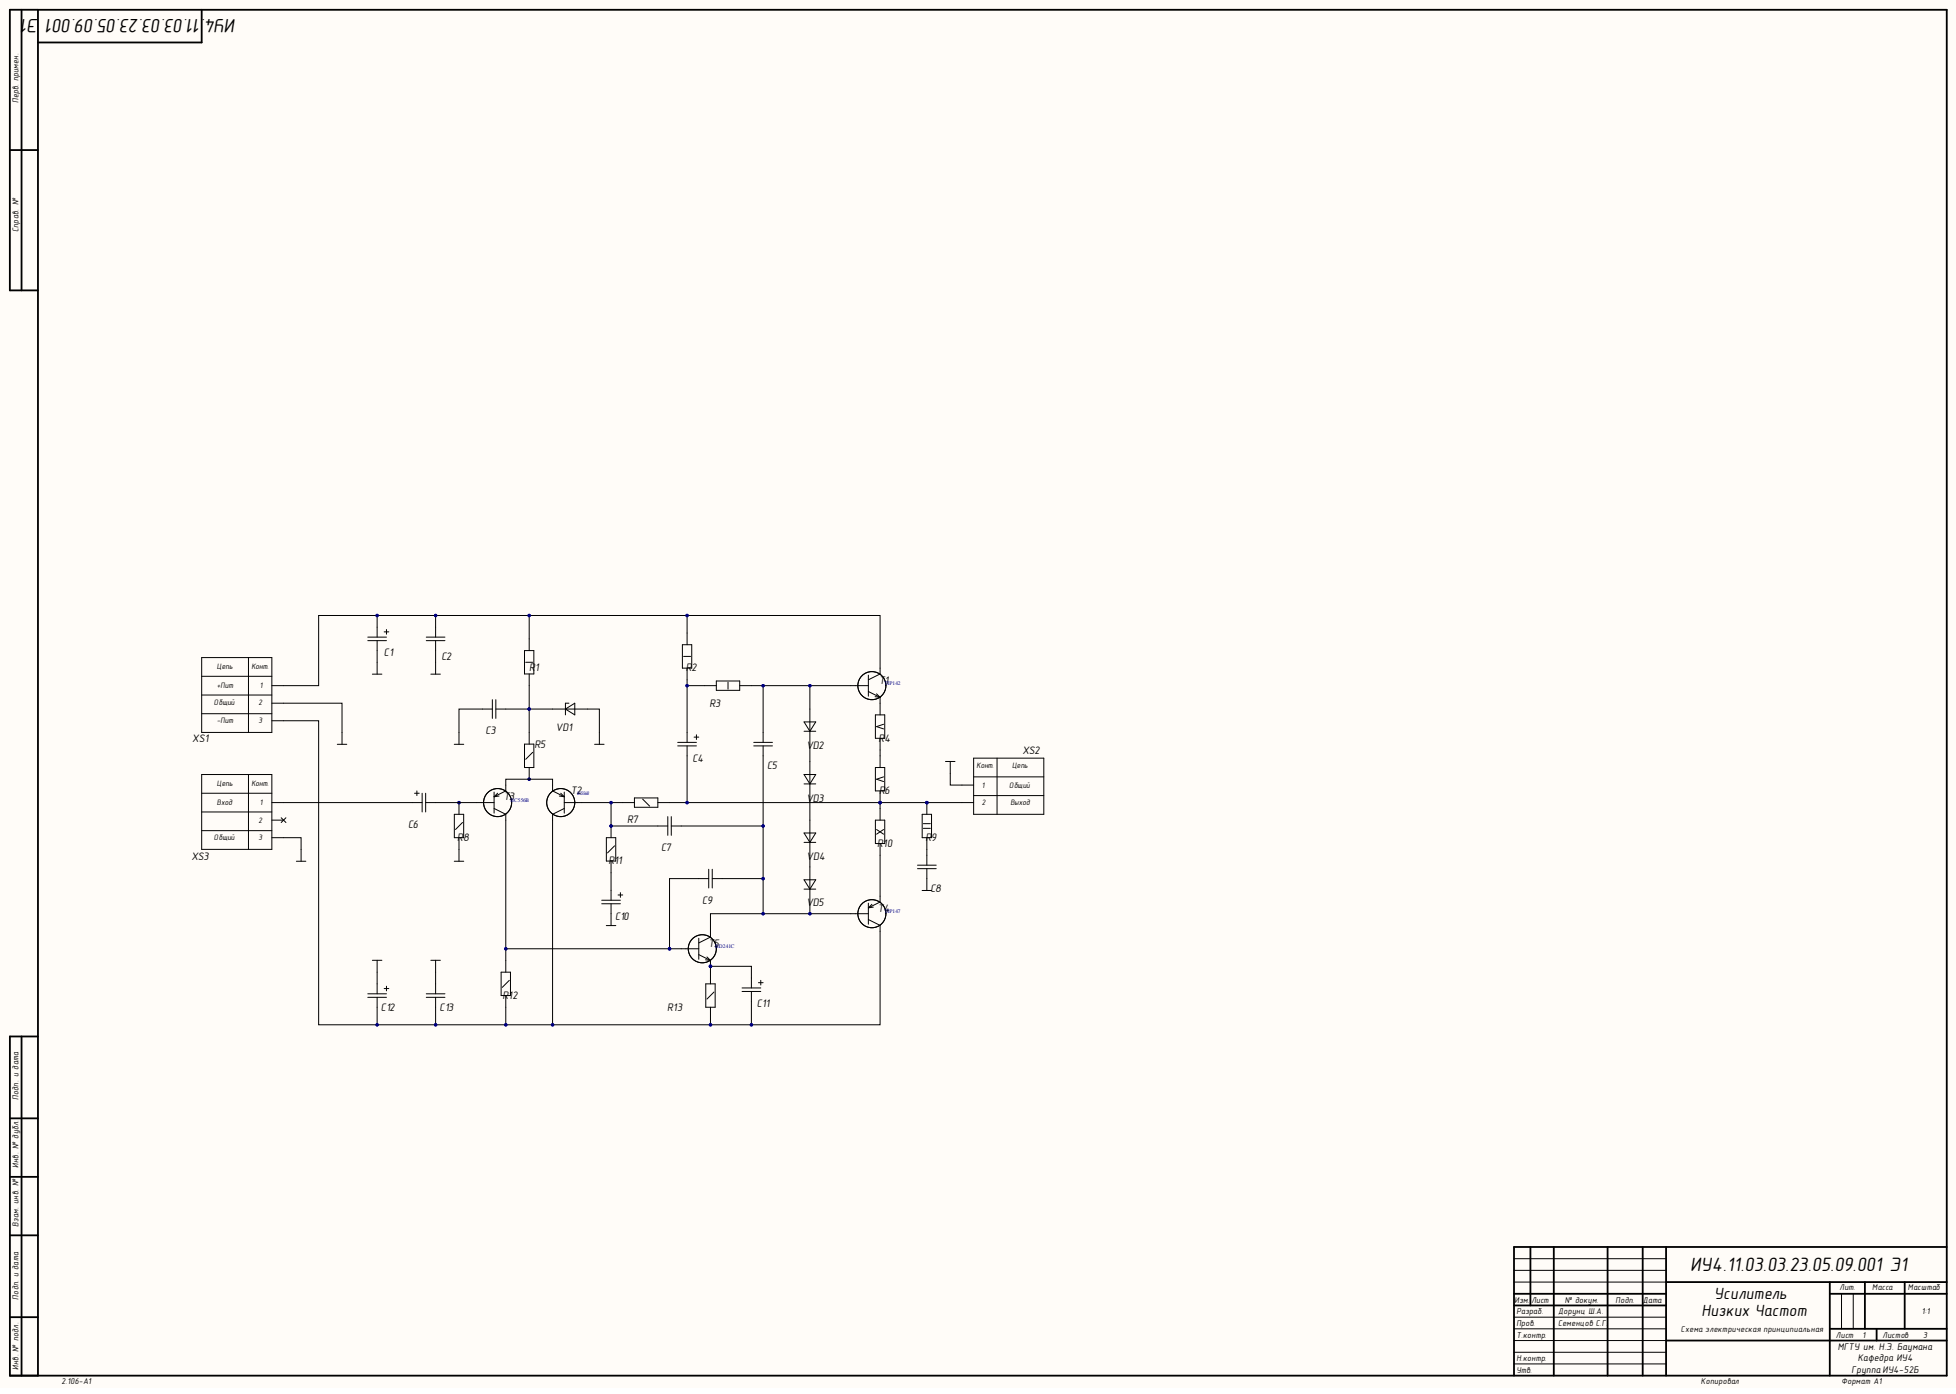
[picture p74: page 1]

Инв. № подл. Инв. № дубл. Подп. и дата Взам. инв. № Подп. и дата Перв. примен. Справ. №

+Пи т
О бщи й | 123

О бщи й

Усилител ь Низких Частот С х е м а э л е к т р и ч е с к а я п р и н ц и п и а л ь н а я | Л и т . | М а с с а | М а с ш т аб

И з м | . Л и с т | № д о к у м . | П о д п . | Д а т а | | | | | 1:1
Р а з р а б . | | Д о р у н ц Ш . А .
П р о в. | | С е м е н ц о в С . Г | .
Т . к о н т р . | | | | | Л и с т 1 | Л и с т о в 3

Н . к о н т р .
У т в.

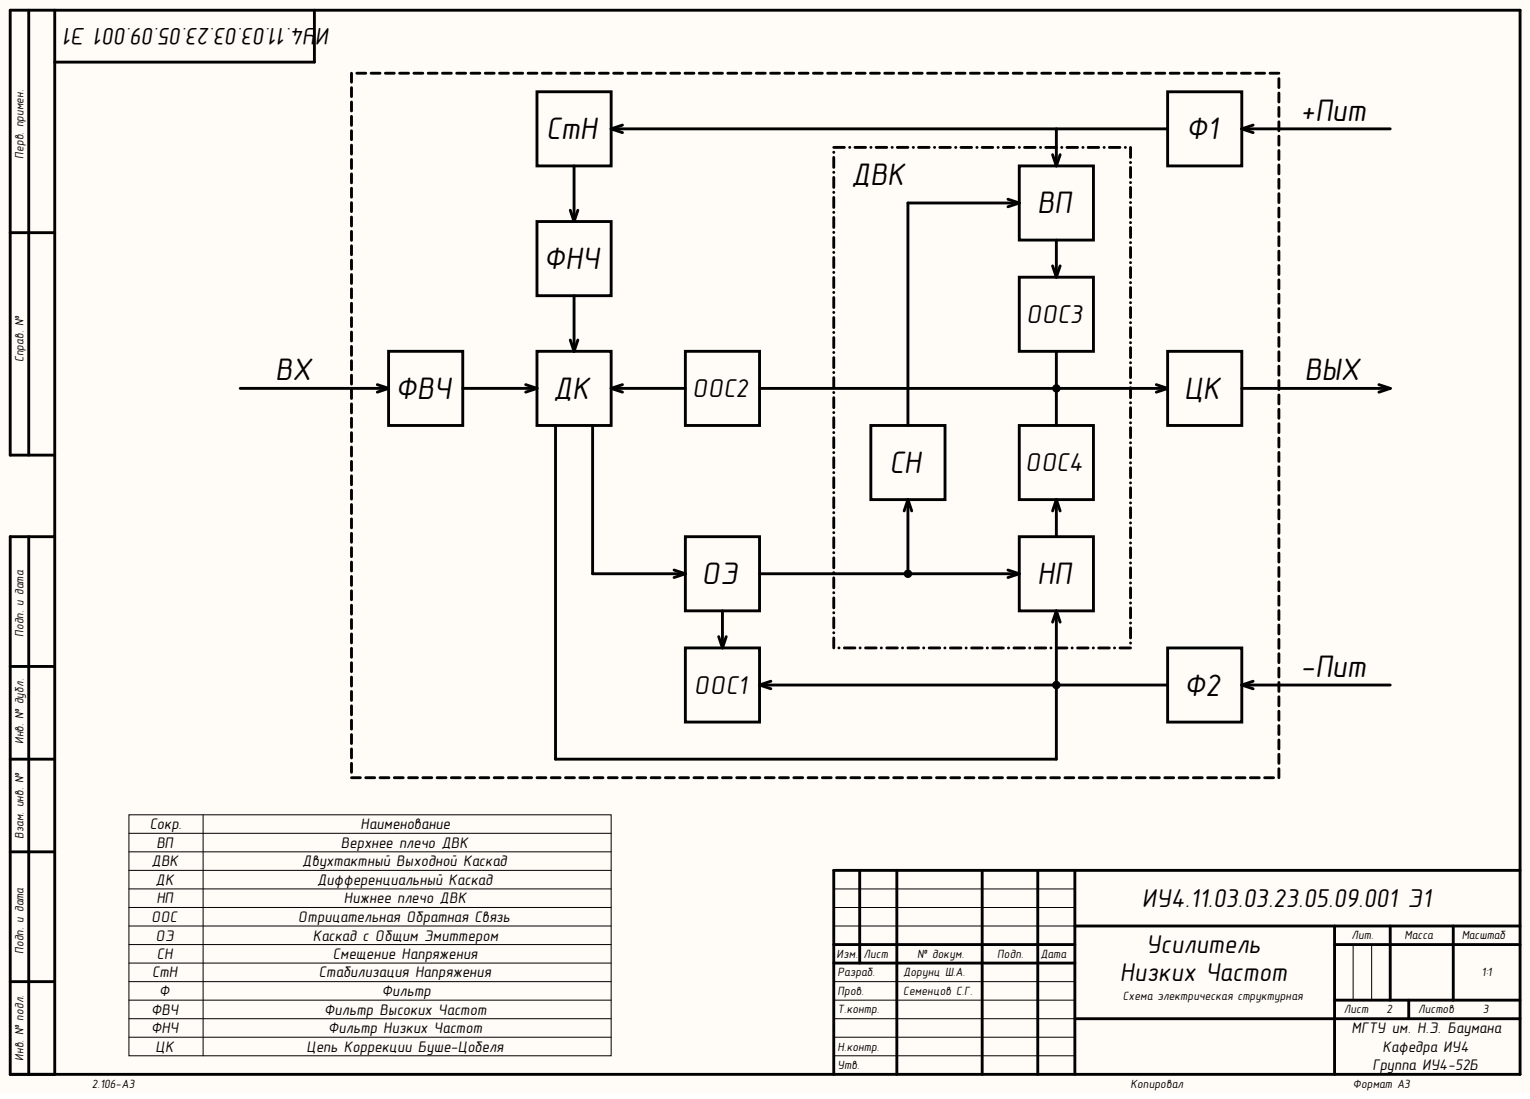
[picture p75: page 2]

Инв. № подл. Инв. № дубл. Подп. и дата Взам. инв. № Подп. и дата Перв. примен. Справ. №

Сокр. | Наименование
ВП | Верхнее плечо ДВК
ДВК | Двухтактный Выходной Каскад

НП | Нижнее плечо ДВК
ООС | Отрицательная Обратная Связь


Инв. № подл. Инв. № дубл. Подп. и дата Взам. инв. № Подп. и дата Перв. примен. Справ. №

Цепь | Конт.

Общий | 2

Конт. | Цепь

2 | Общий

Общий | 1

1 | Вход

Блок | Наименование

А1 | Источник питания двуполярный ±20В

Т.контр. | Лист 3 | Листов 3

МГТУ им. Н.Э. Баумана Кафедра ИУ4 Группа ИУ4-52Б

Н.контр.
Утв.

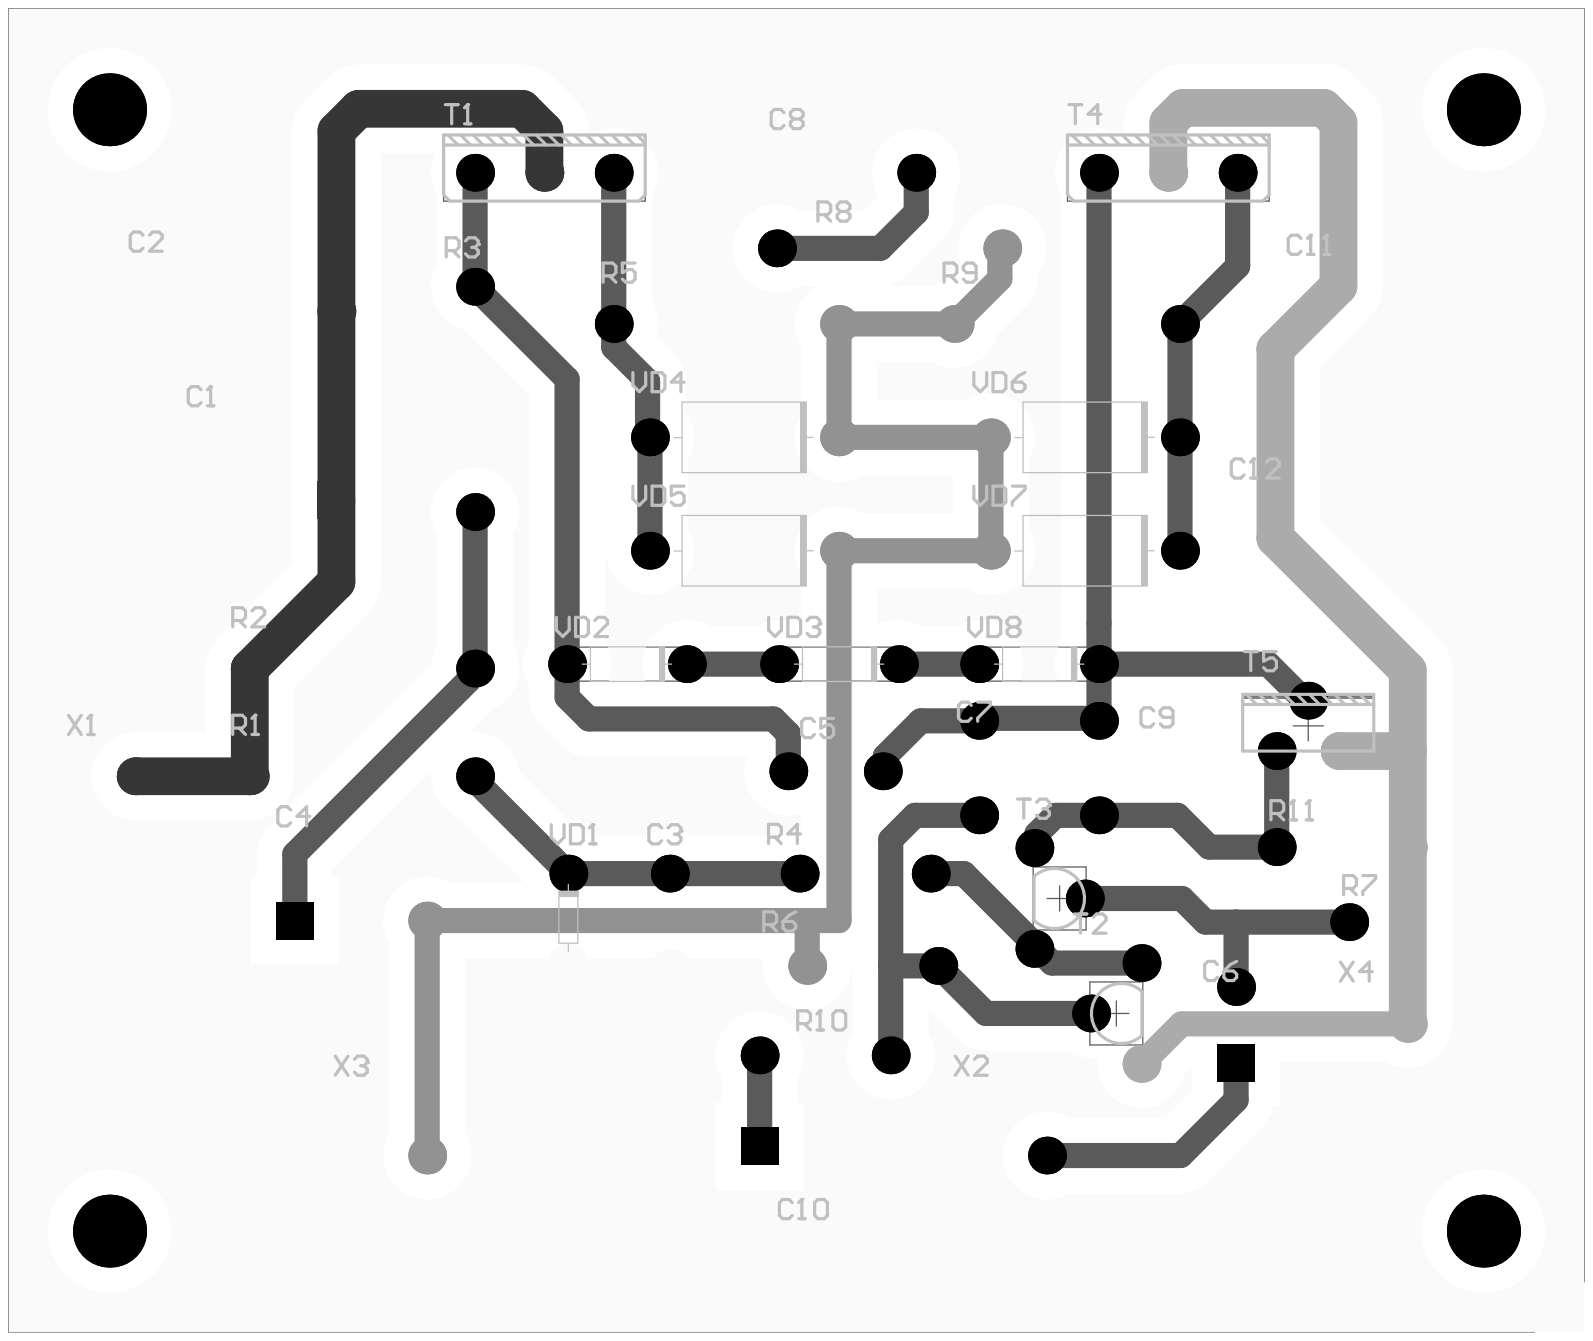
[picture p76: page 4]

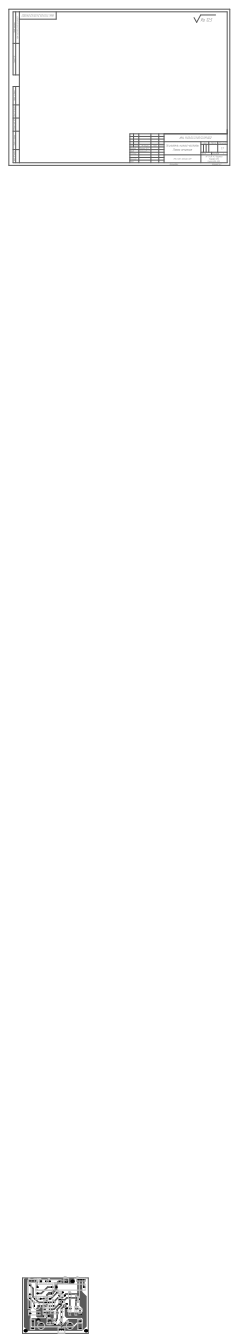
[picture p77: page 5]
