sdorunts/Low-Freq-Amp/Documentation/ИС_Дорунц.pdf

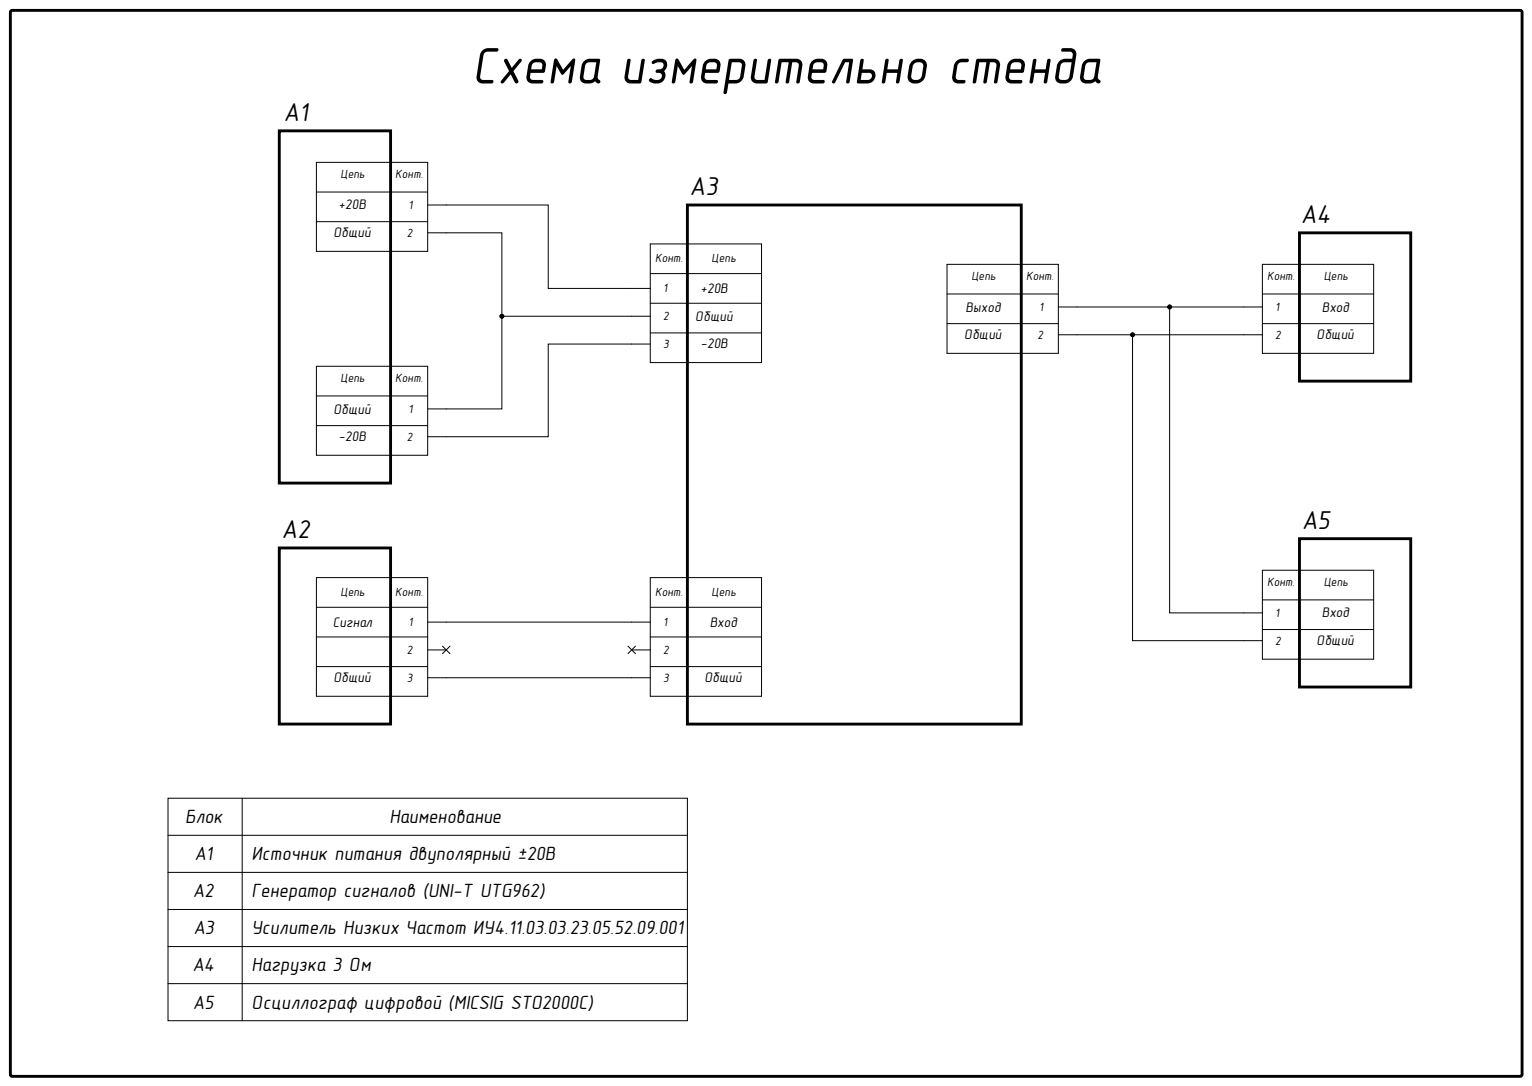
[picture p78: page 1]

Цепь | Конт.

Общий | 2

Конт. | Цепь

2 | Общий

Общий | 1

1 | Вход

Блок | Наименование

А1 | Источник питания двуполярный ±20В

А2 | Генератор сигналов (UNI-T UTG962)

А3 | Усилитель Низких Частот ИУ4.11.03.03.23.05.52.09.001

А4 | Нагрузка 3 Ом

А5 | Осциллограф цифровой (MICSIG STO2000C)
