sdorunts/Low-Freq-Amp/Documentation/СБ_Дорунц.pdf

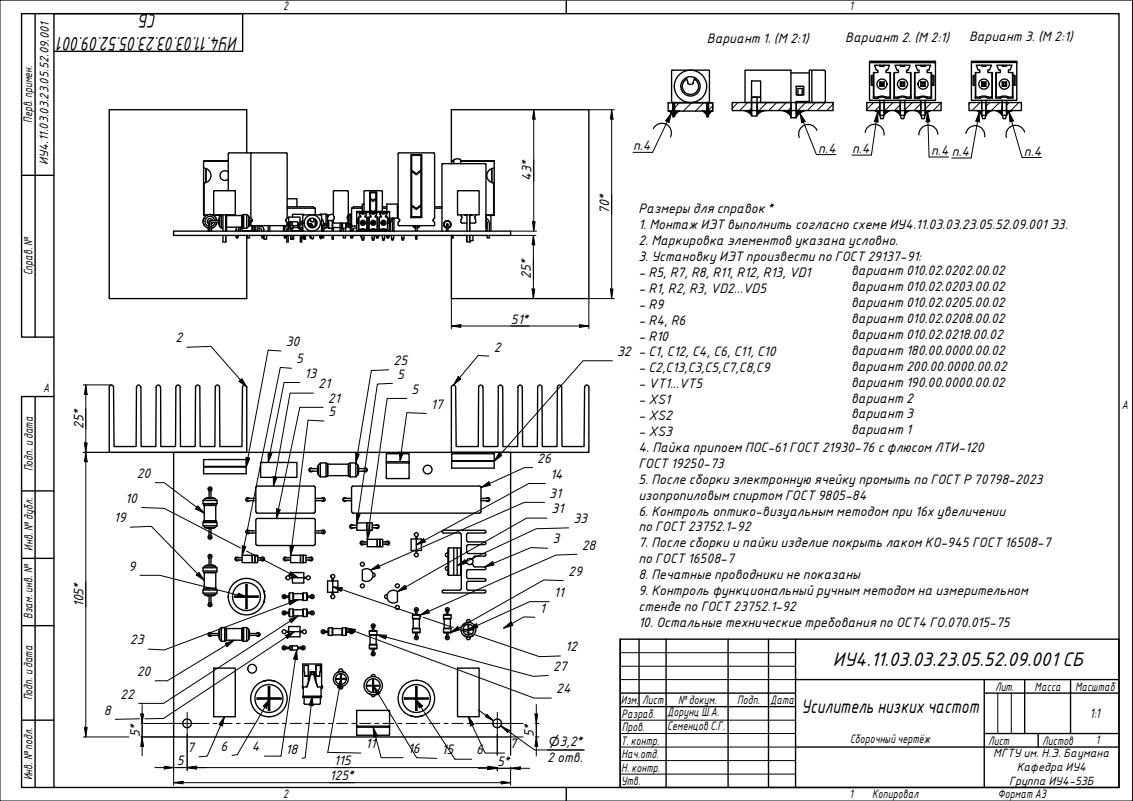
[picture p79: page 1]
Формат А3; Инв. №; л. Под; бл. Под; Перв. п; Вариант 1. (М 2:1); Вариант 2. (М 2:1); Вариант 3. (М 2:1); вариант 010.02.0202.00.02 вариант 010.02.0203.00.02 вариант 010.02.0205.00.02 вариант 010.02.0208.00.02 вариант 010.02.0218.00.02 вариант 180.00.0000.00.02 вариант 200.00.0000.00.02 вариант 190.00.0000.00.02 вариант 2 вариант 3 вариант 1; 2 отв.

Размеры для справок *
1. Монтаж ИЭТ выполнить согласно схеме ИУ4.11.03.03.23.05.52.09.001 Э3.
2. Маркировка элементов указана условно.
3. Установку ИЭТ произвести по ГОСТ 29137-91:
4. Пайка припоем ПОС-61 ГОСТ 21930-76 с флюсом ЛТИ-120
ГОСТ 19250-73
5. После сборки электронную ячейку промыть по ГОСТ Р 70798-2023
изопропиловым спиртом ГОСТ 9805-84
6. Контроль оптико-визуальным методом при 16x увеличении
по ГОСТ 23752.1-92
7. После сборки и пайки изделие покрыть лаком КО-945 ГОСТ 16508-7
по ГОСТ 16508-7

8. Печатные проводники не показаны
9. Контроль функциональный ручным методом на измерительном
стенде по ГОСТ 23752.1-92
10. Остальные технические требования по ОСТ4 ГО.070.015-75

Усилитель низких частот Сборочный чертёж | Лит. | Масса | Масштаб

Изм. | Лист | № докум. | Подп. | Дата | | | | | 1:1
Разраб. | | Дорунц Ш.А.
Пров. | | Семенцов С.Г.
Т. контр. | | | | | Лист | Листов 1
Нач.отд. | | | | | МГТУ им. Н.Э. Баумана Кафедра ИУ4 Группа ИУ4-53Б
Н. контр.
Утв.
