sdorunts/Low-Freq-Amp/Project Outputs for Kursovaya/Job1.PDF

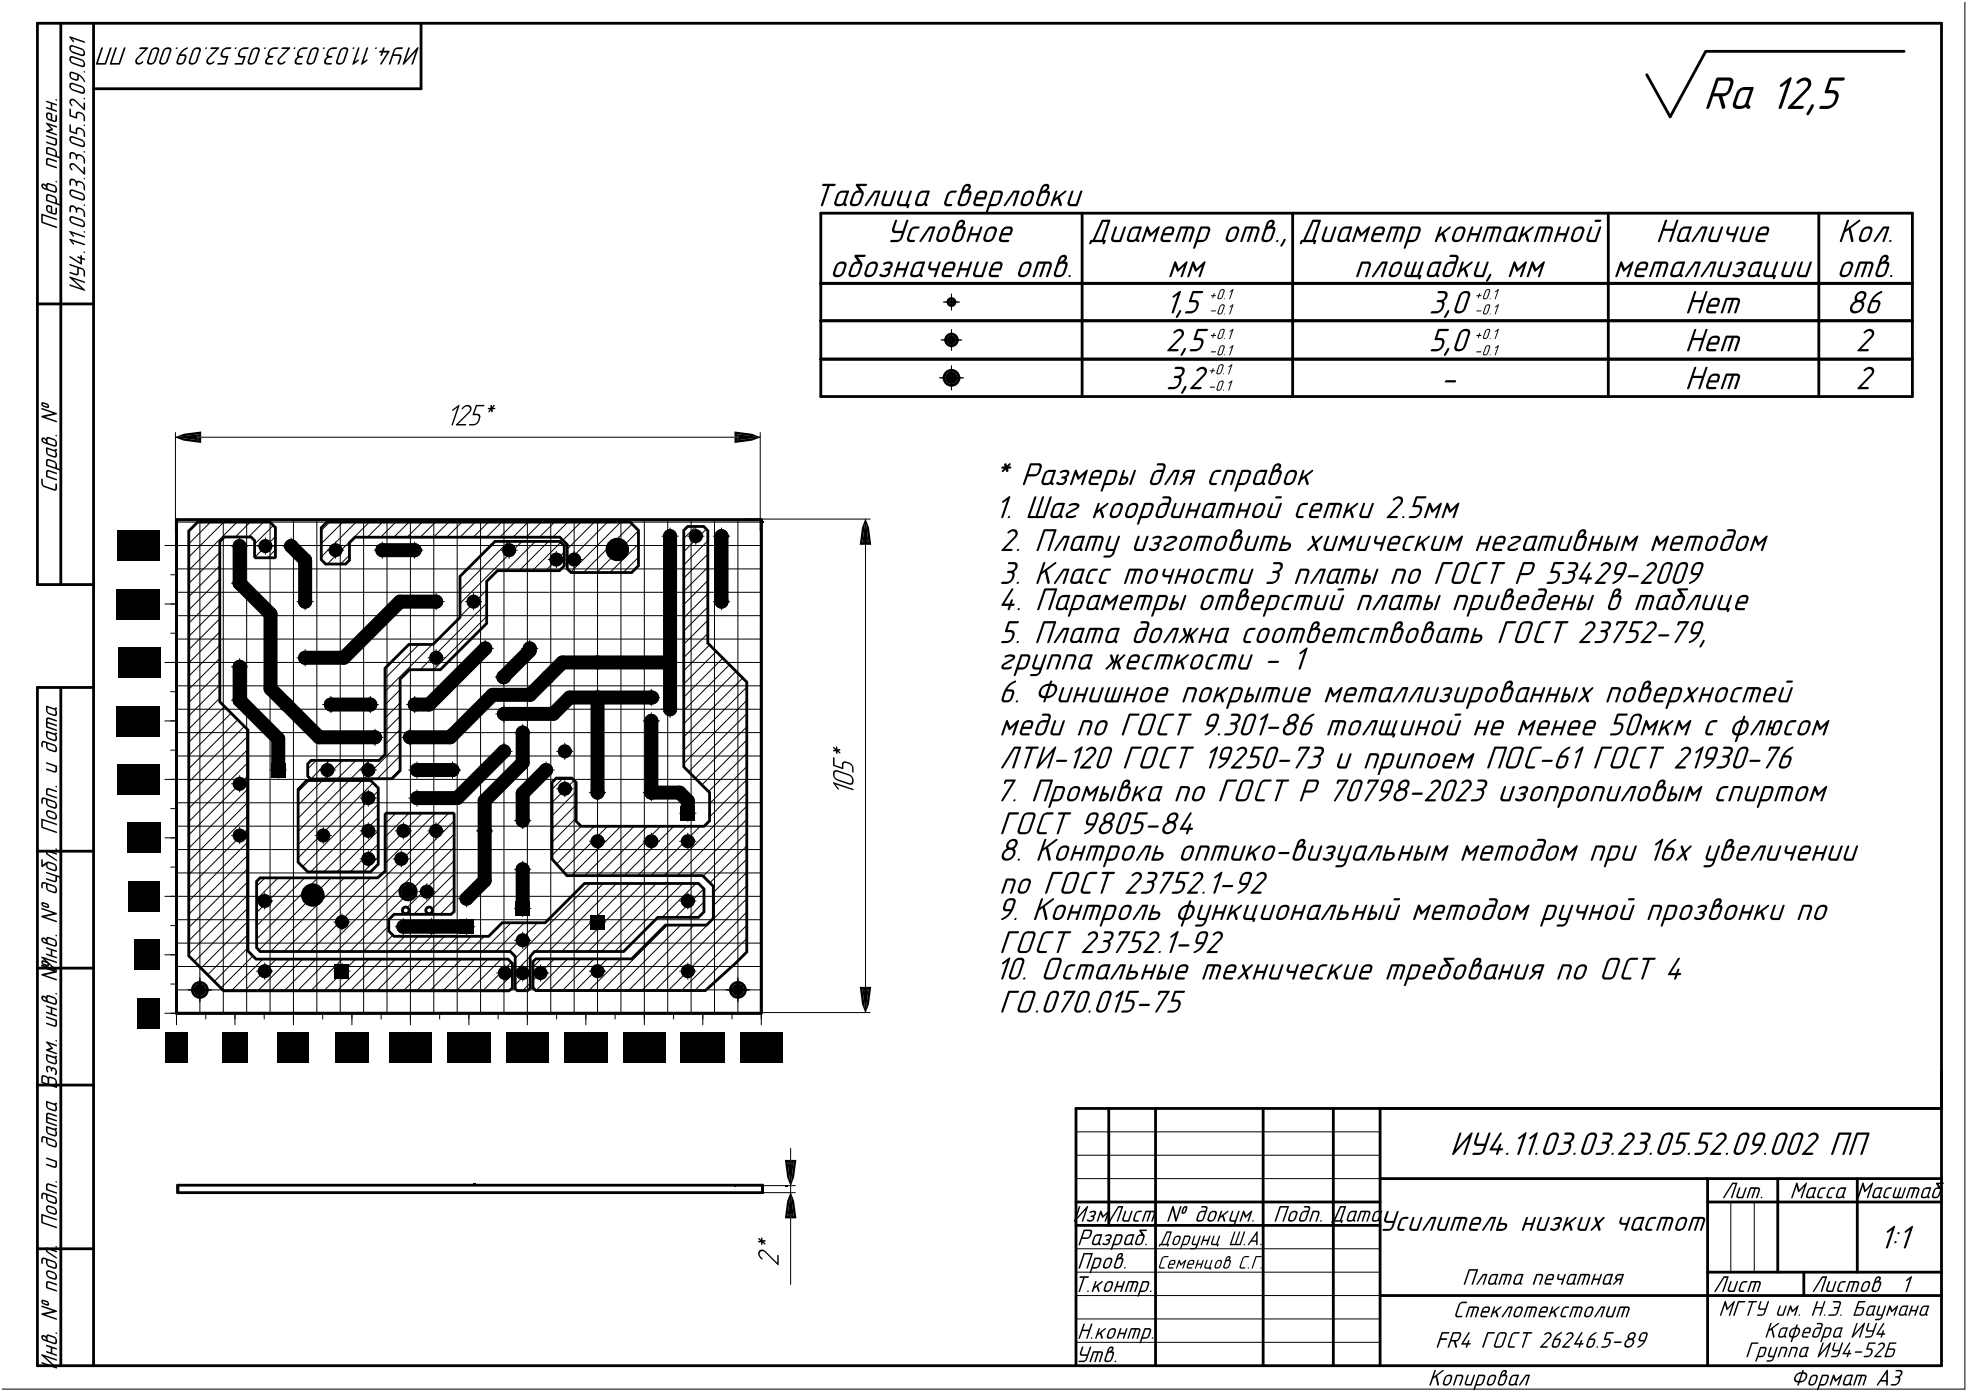
[picture p80: page 1]
