sdorunts/Low-Freq-Amp/Documentation/Э3_Дорунц.pdf

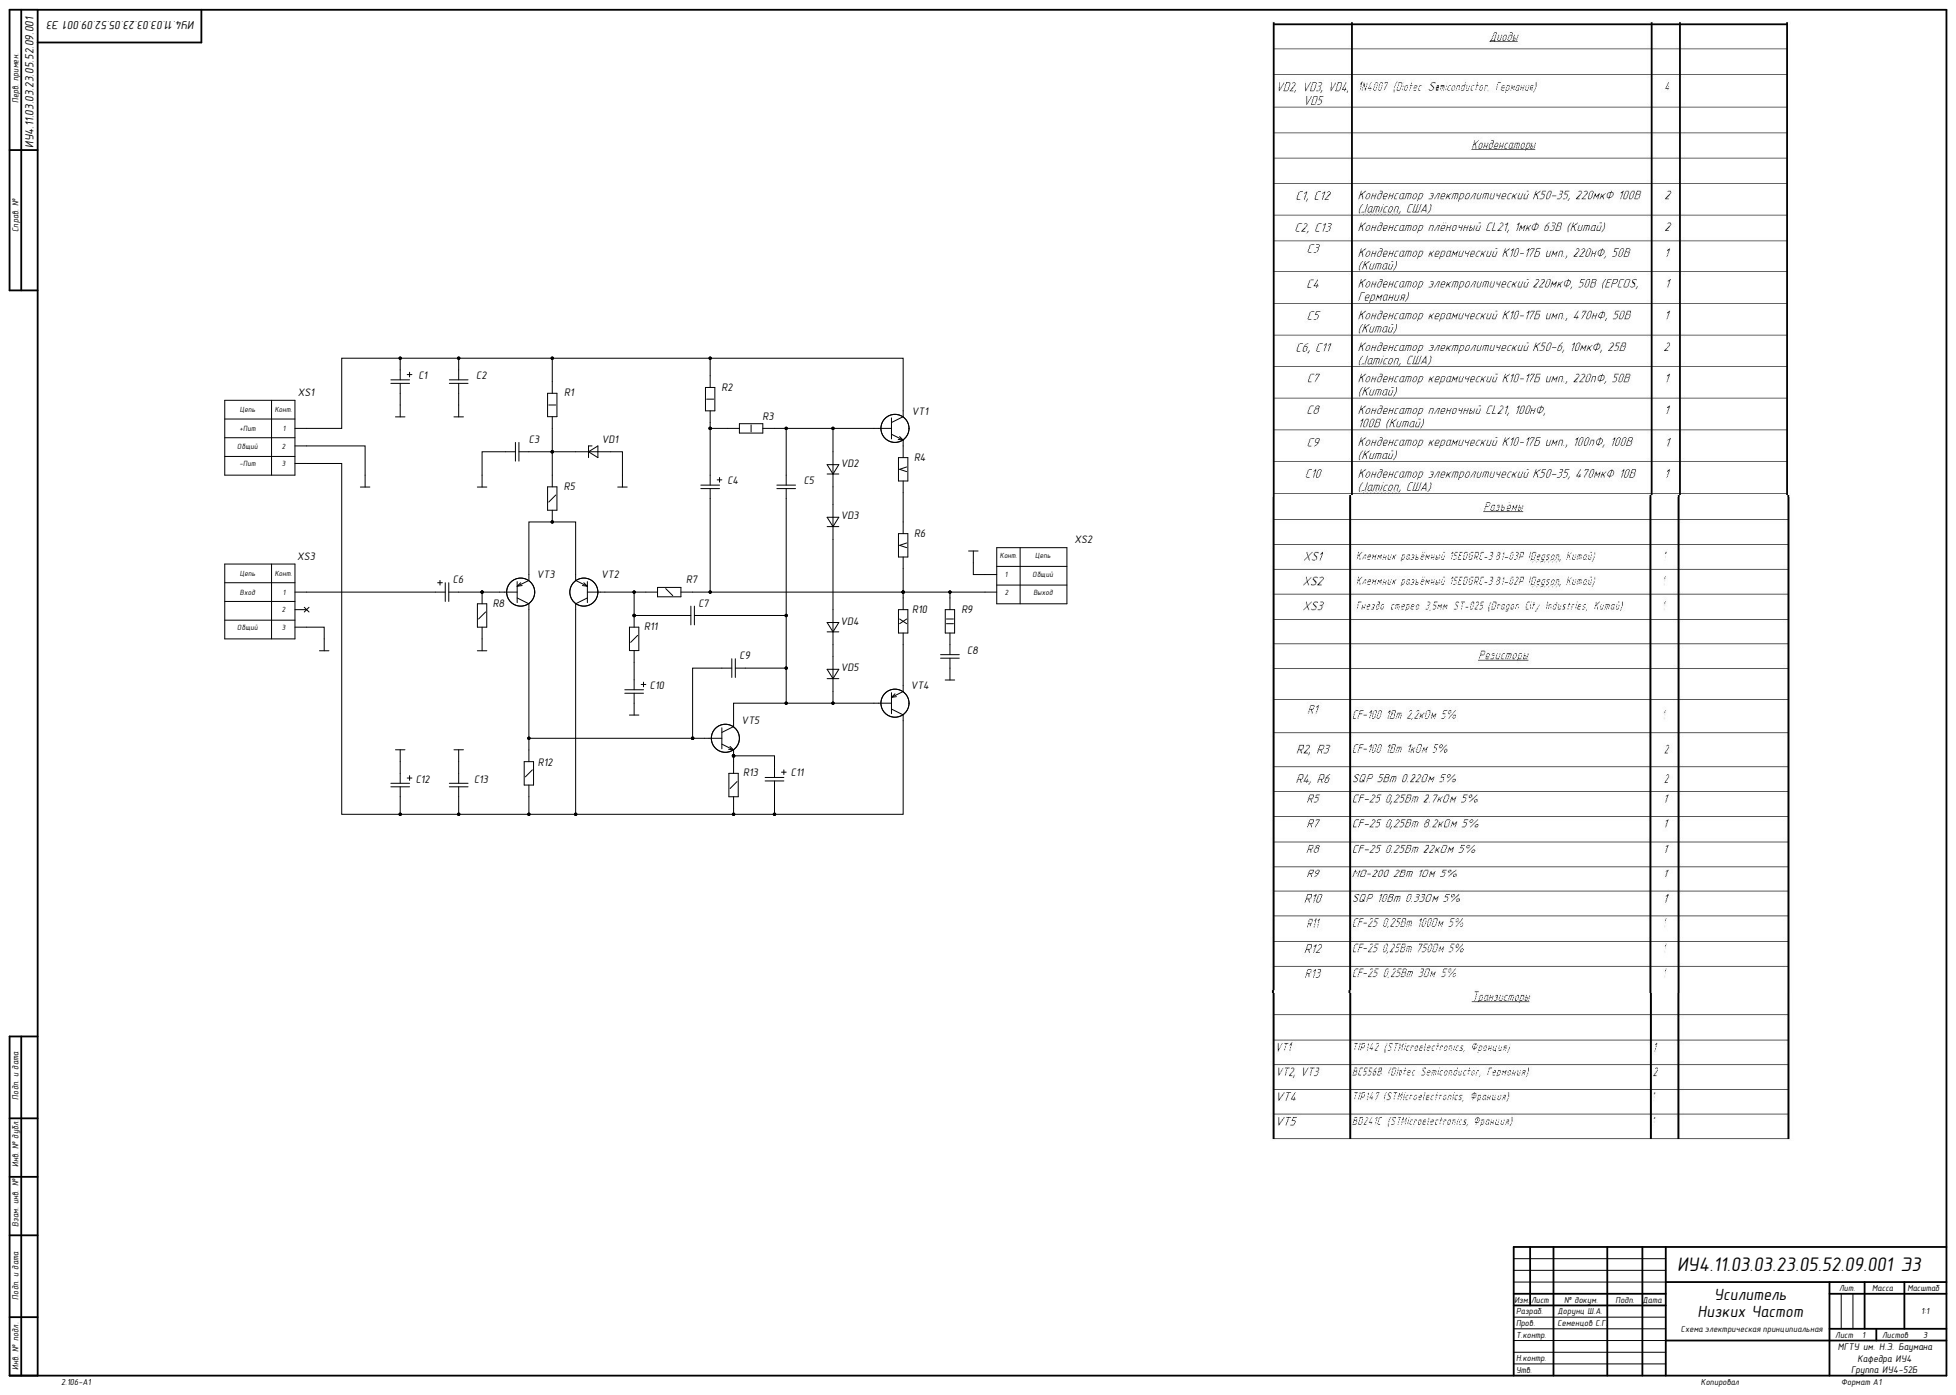
[picture p81: page 1]

Инв. № подл. Инв. № дубл. Подп. и дата Взам. инв. № Подп. и дата Перв. примен. Справ. №

Цепь | Конт | .

+ Пит

-Пит

В ыход

Общий

Усилите л ь Дорунц Ш.А. Низких Частот Схема электрическая принципиальная | Лит . | Масс а | Масшт аб

Изм | . Лис т | № докум . | Подп . | Дат а | | | | | 1:1
Разраб.
Пров . | | Семенцов С . Г | .
Т .конт р . | | | | | Лис т 1 | Лист о в 3

МГТ У им . Н . Э . Баумана Кафедра И У 4 Группа И У 4 -5 2 Б

Н .конт р .
Утв .
