sdorunts/Low-Freq-Amp/(list of files, drawings)

Other design files:
Kursovaya.PcbLib
Kursovaya.PrjPcb
Kursovaya.SCHLIB
PCBv1.PcbDoc
PCBv2.PcbDoc
ПД1.SchDoc
Э1.SchDoc
Э3А1.SchDoc
Э3А3.SchDoc
