sdorunts/Low-Freq-Amp/(commit log)

2023-11-22 Init commit
    [Kursovaya.PcbLib, Kursovaya.PrjPcb, PCBv1.PcbDoc, SchemeGOST.SchDoc]
2023-12-07 PCBv2 was routed; OutJob files was added; Scheme was simulated; Simulation output files was added
    [Kursovaya.PcbLib, Kursovaya.PrjPcb, PCBv1.PcbDoc, PCBv2.PcbDoc, SchemeGOST.SchDoc, Scheme_Sim.sch]
2023-12-09 PCB exported to STEP; Some documentation was made
    [10_13.5x5.5h11.ipt, 15EDGRC-3.81-02P-14-00A(H)_RGB5220458.ipt, 15EDGRC-3.81-03P-14-00A(H)_RGB5220458.ipt, 6493613120.iam, 6493613360.iam, Audio Jack 3.5 mm Cliff FC68125.iam, Board.iam, C1.iam]
2023-12-09 A3H1 Template was customized; Э1, Э3, ИС sheets was finalized
    [PCBv2.PcbDoc, SchemeGOST.SchDoc, ИС.SchDoc, Э1.SchDoc]
2023-12-09 SchemeGOST sheet was renamed to Э3А3
    [SchemeGOST.SchDoc, Э3А3.SchDoc]
2023-12-09 Sheet1.SchDoc was deleted
    [Sheet1.SchDoc, Э3А3.SchDoc]
2023-12-09 Э3А3 was changed to Э3А1
    [Э1.SchDoc, Э3А1.SchDoc, Э3А3.SchDoc]
2023-12-10 ПД2, ПЭ, СП added; practical data added
    [10_13.5x5.5h11.0001.ipt, 10_13.5x5.5h11.ipt, 15EDGRC-3.81-02P-14-00A(H)_RGB5220458.0001.ipt, 15EDGRC-3.81-02P-14-00A(H)_RGB5220458.ipt, 15EDGRC-3.81-03P-14-00A(H)_RGB5220458.0001.ipt, 15EDGRC-3.81-03P-14-00A(H)_RGB5220458.ipt, 6504176576.iam, 6504176816.iam]
2023-12-14 Full documentation set added
    [Kursovaya.PcbLib, Kursovaya.PrjPcb, PCBv2.PcbDoc, Scheme_Sim.sch, ИС.SchDoc, Э1.SchDoc, Э3А1.SchDoc, Э3А3.SchDoc]
2023-12-19 Full documentation changed and corrected
    [10_13.5x5.5h11.0001.ipt, 10_13.5x5.5h11.ipt, 15EDGRC-3.81-02P-14-00A(H)_RGB5220458.0001.ipt, 15EDGRC-3.81-02P-14-00A(H)_RGB5220458.ipt, 15EDGRC-3.81-03P-14-00A(H)_RGB5220458.0001.ipt, 15EDGRC-3.81-03P-14-00A(H)_RGB5220458.ipt, 6338724944.iam, 6338725344.iam]
